ber2rv/fluidic/README.md

# fluidic
This repository contains the Electronics to control the pumps, in a fluidic system, among other things
