ber2rv/fluidic/fluidics/screengrabs/Bottom_Layer.png

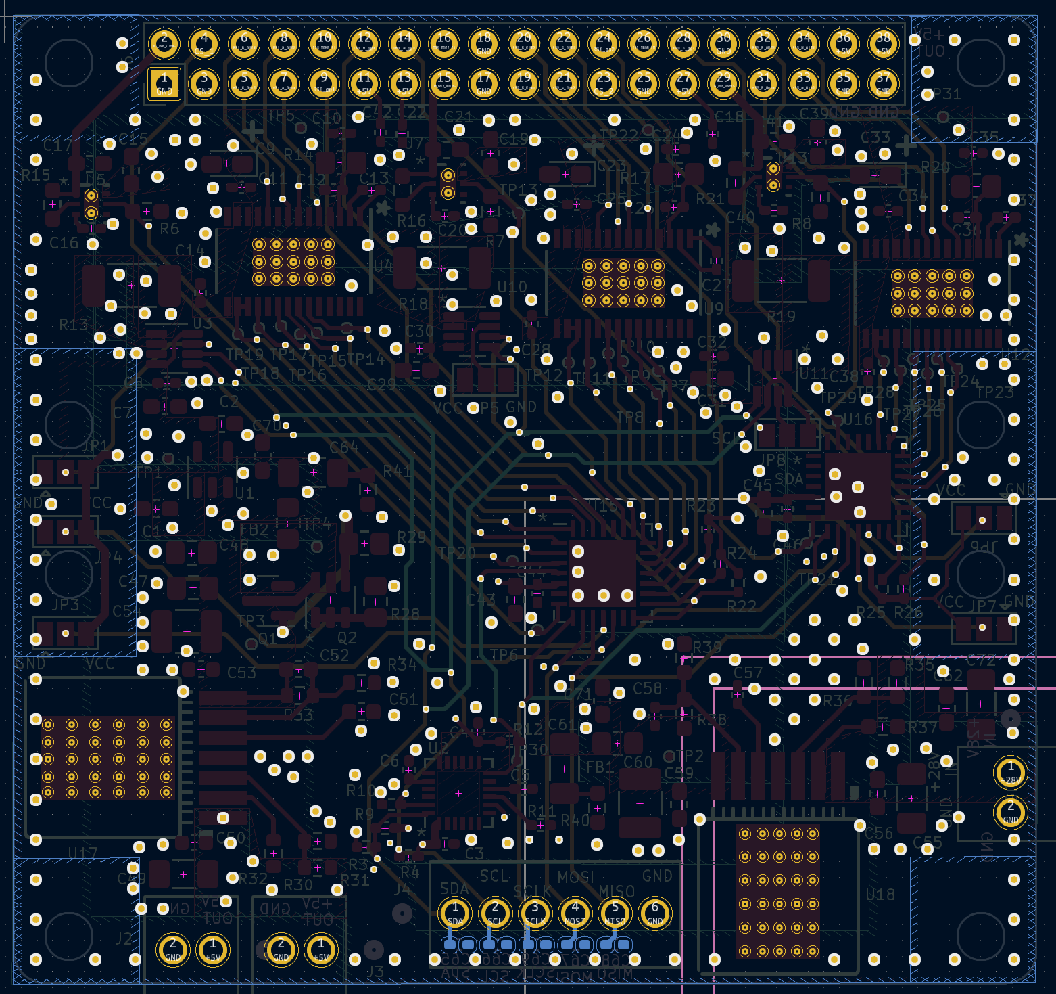
fluidics/screengrabs/Bottom_Layer.png
