ber2rv/fluidic/fluidics/screengrabs/Bottom_Layer_Cu_highlighted.png

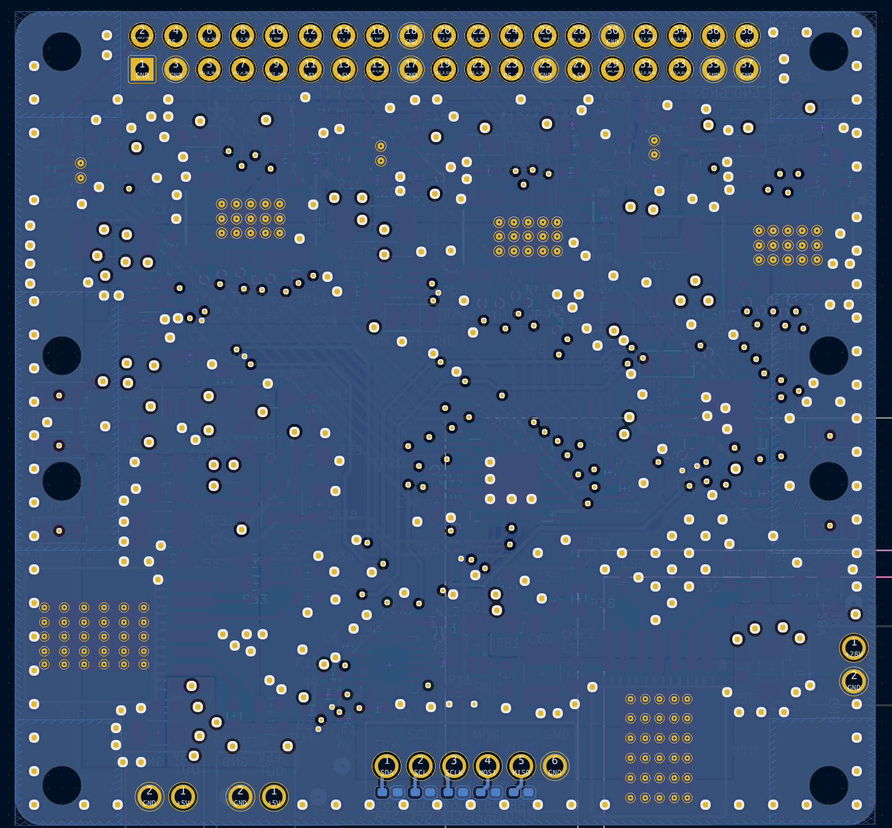
fluidics/screengrabs/Bottom_Layer_Cu_highlighted.png
