ber2rv/fluidic/fluidics/screengrabs/Inner_layer_1.png

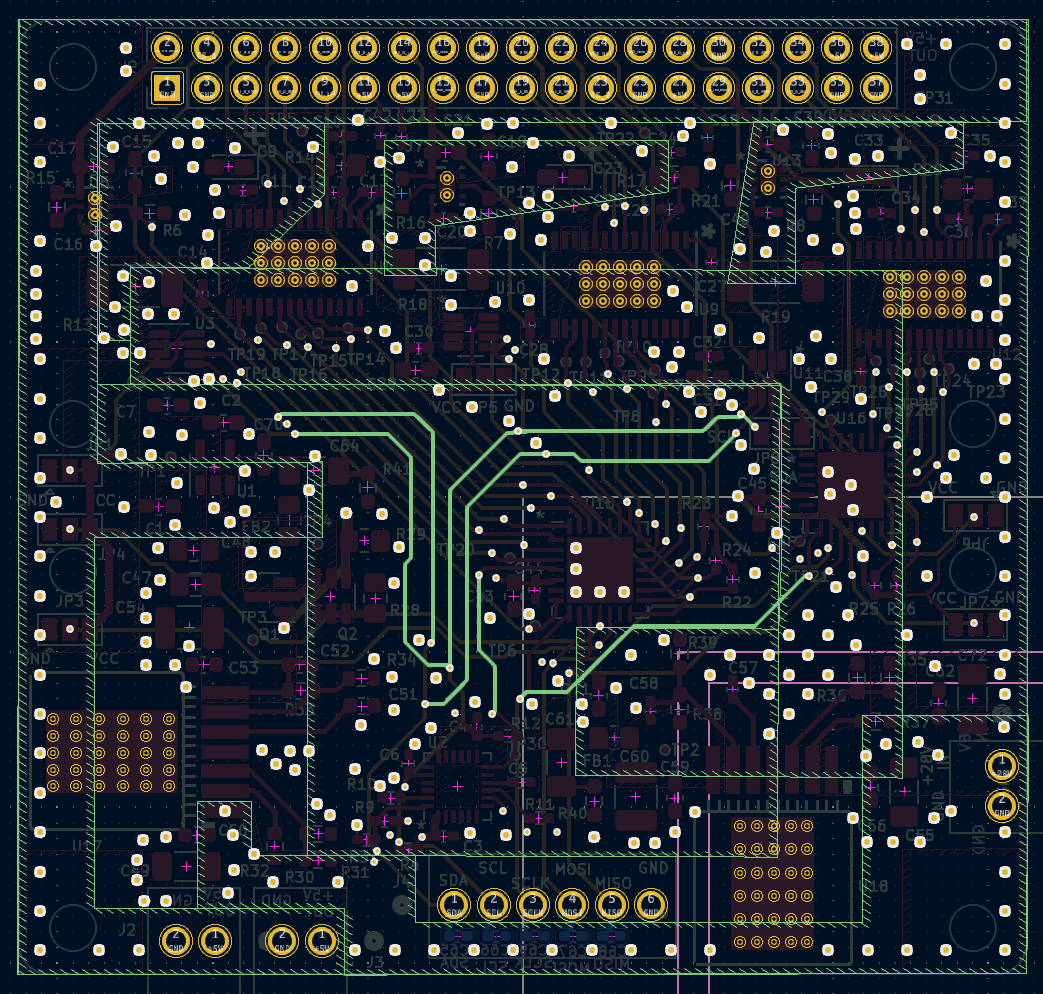
fluidics/screengrabs/Inner_layer_1.png
