ber2rv/fluidic/fluidics/screengrabs/Inner_layer_2.png

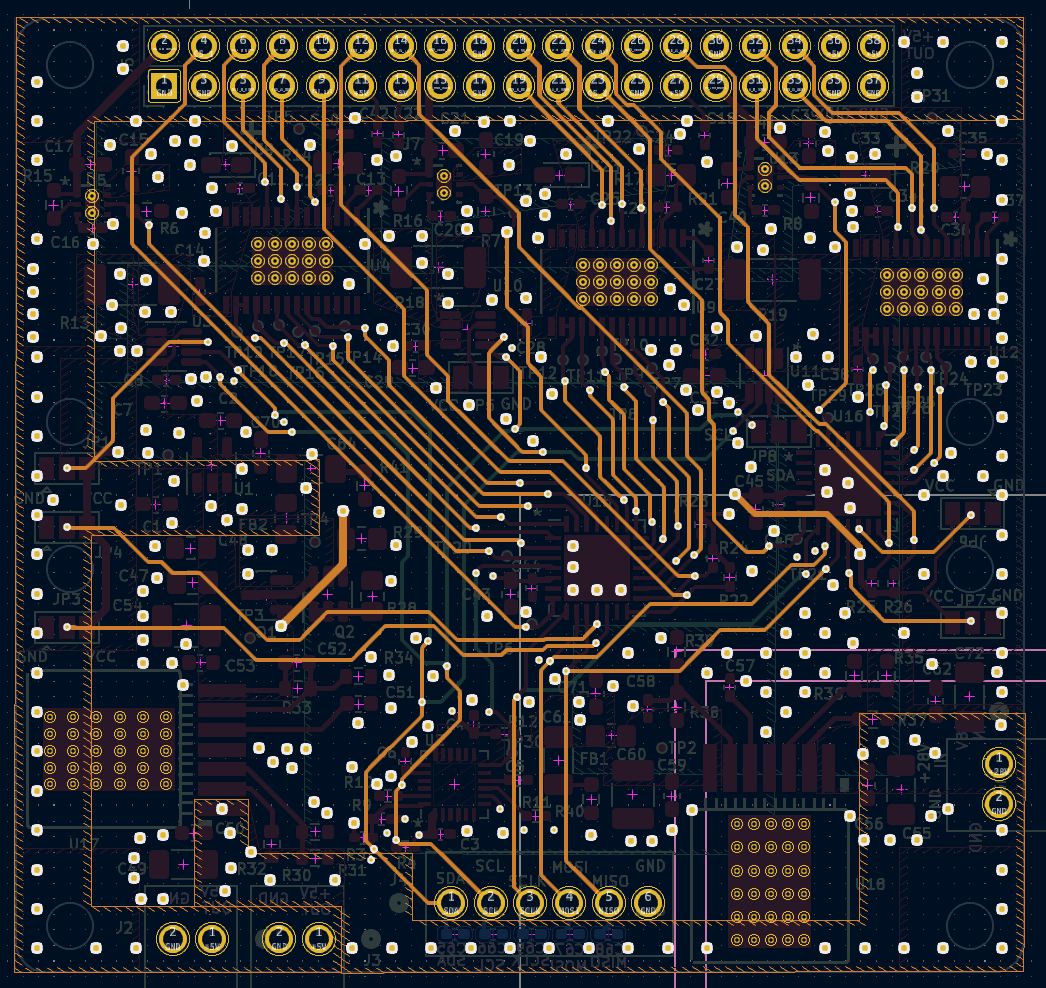
fluidics/screengrabs/Inner_layer_2.png
