ber2rv/fluidic/fluidics/screengrabs/Inner_layer_2_Cu_highlighted.png

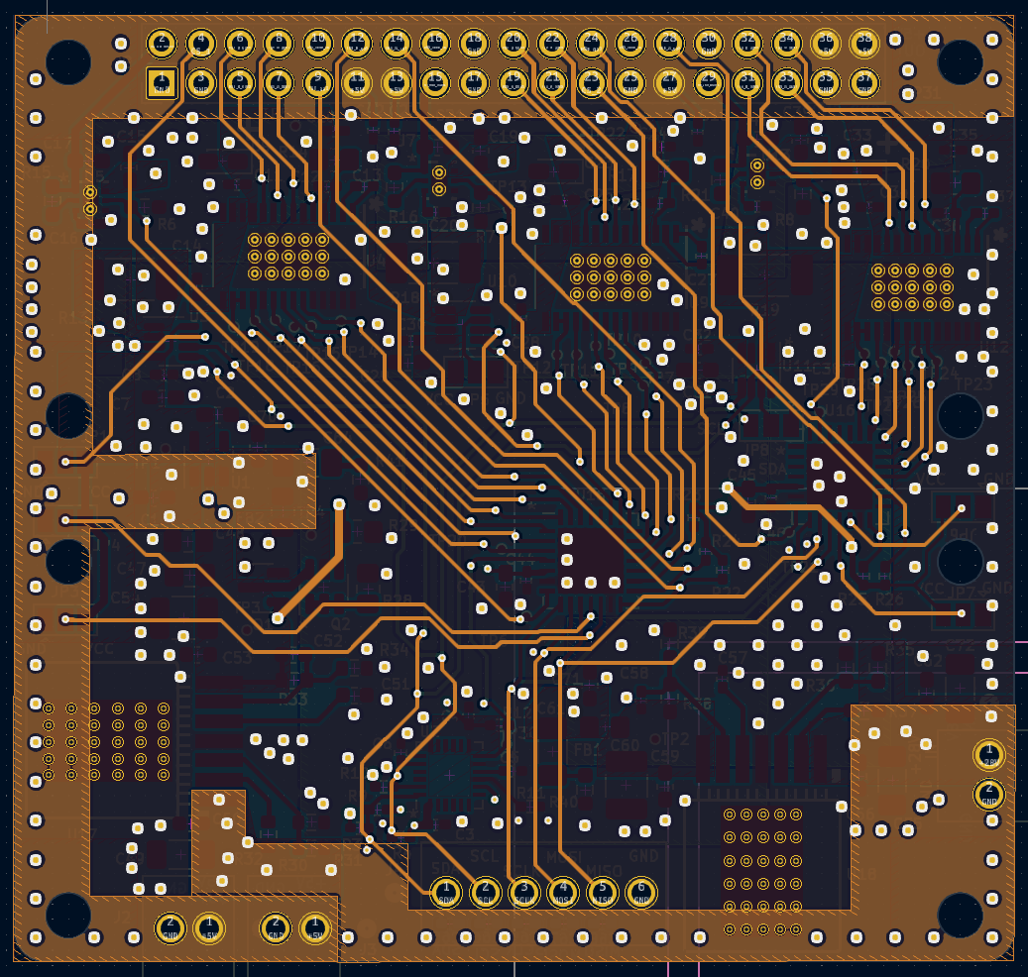
fluidics/screengrabs/Inner_layer_2_Cu_highlighted.png
