ber2rv/fluidic/fluidics/screengrabs/Top_Layer.png

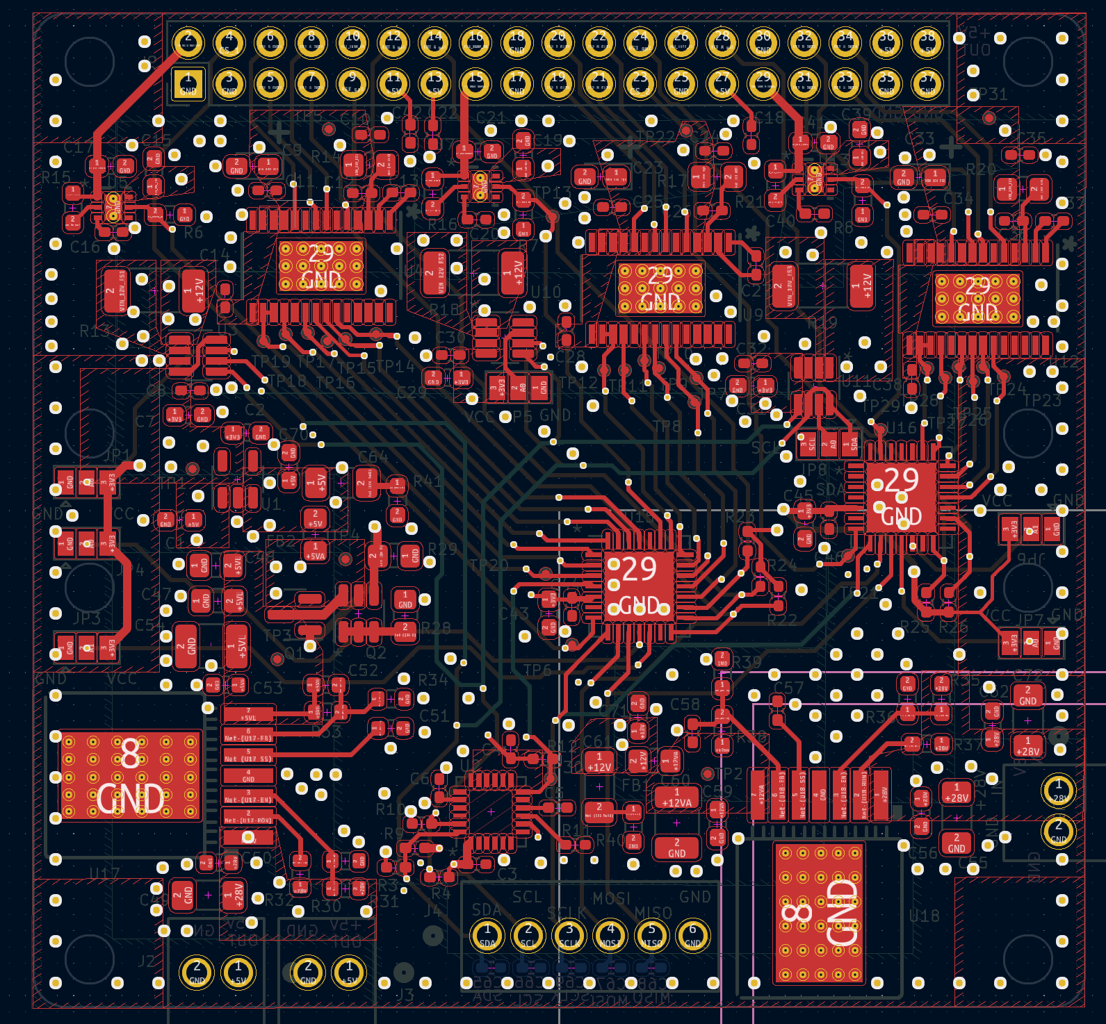
fluidics/screengrabs/Top_Layer.png
