ber2rv/fluidic/fluidics/screengrabs/Top_Layer_Cu_highlighted.png

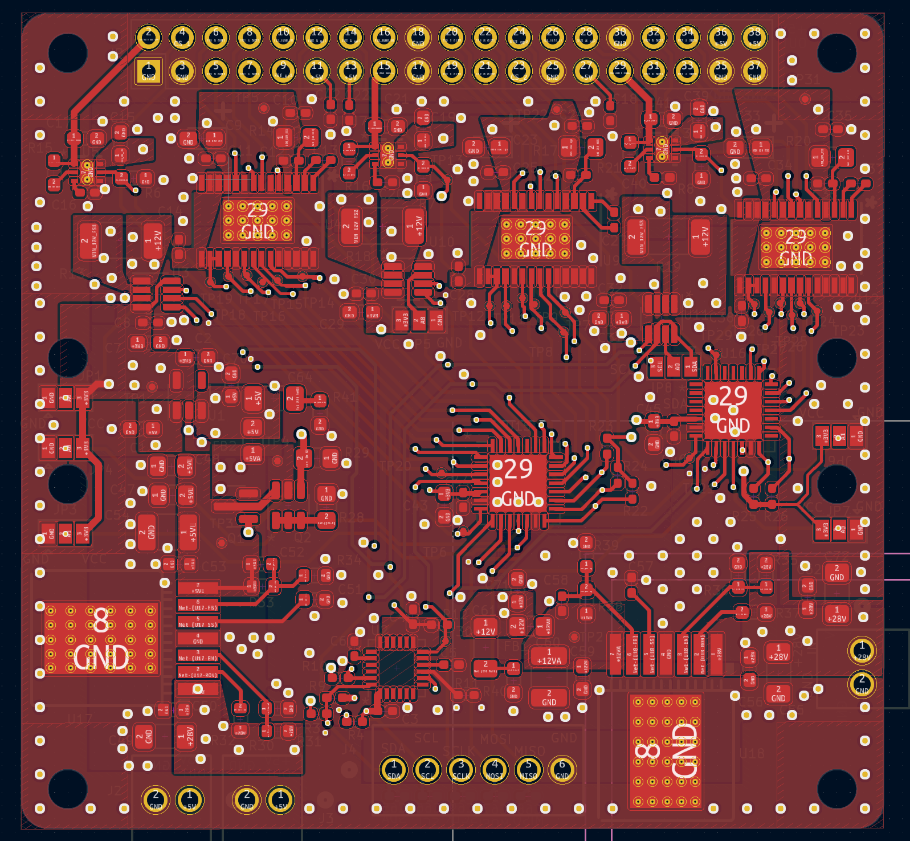
fluidics/screengrabs/Top_Layer_Cu_highlighted.png
