ber2rv/fluidic/fluidics/schematics_pdf/fluidics.pdf

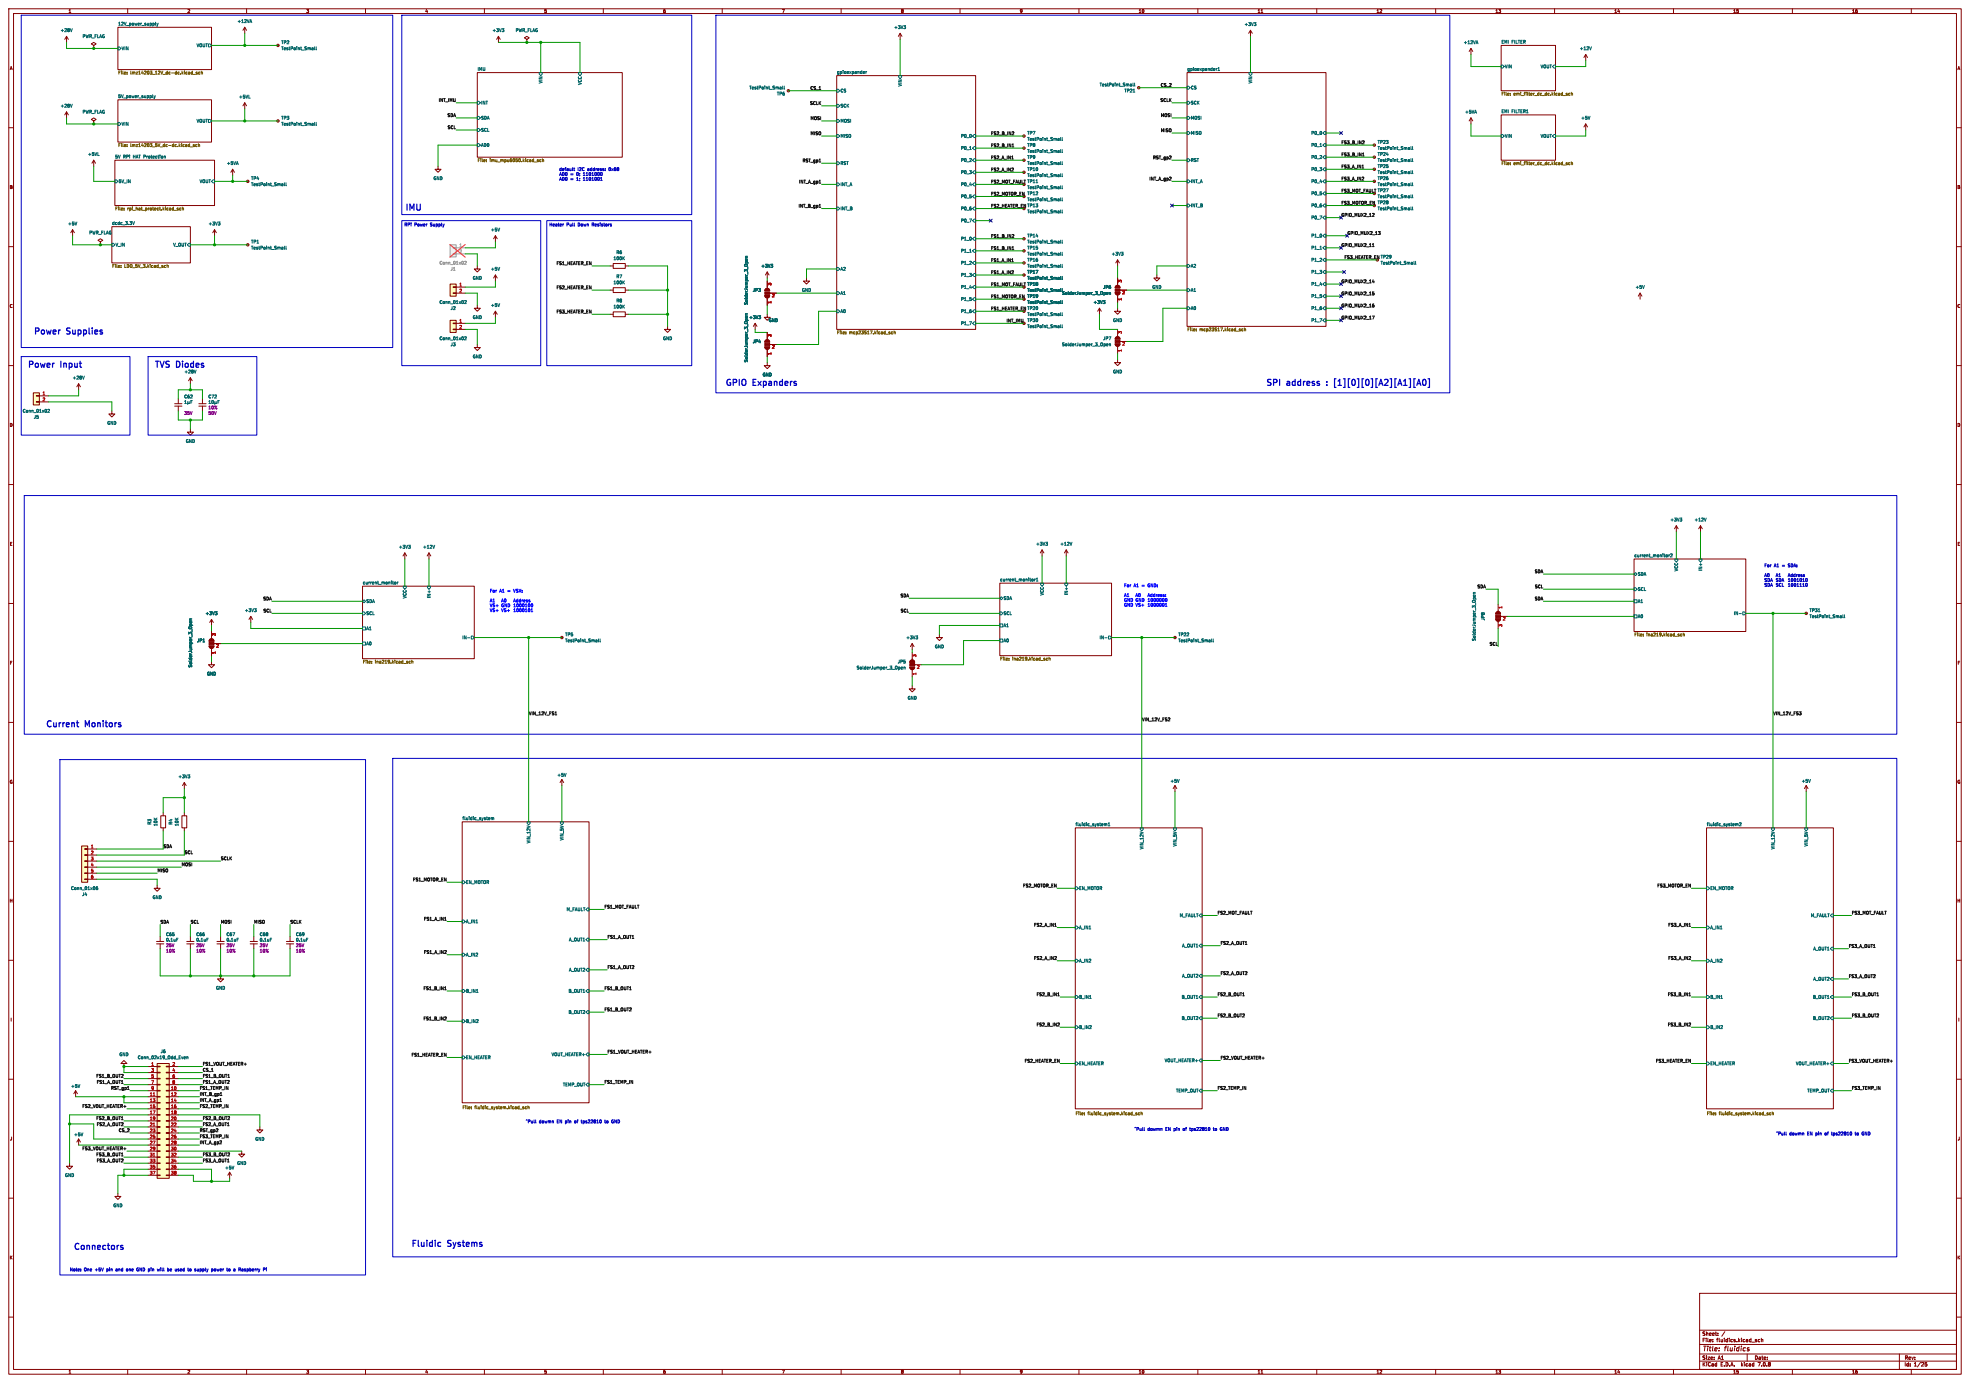
[picture p9: page 1]

For A1 = SDA: A0 A1 Address SDA SDA 1001010 SDA SCL 1001110

For A1 = GND: A1 A0 Address: GND GND 1000000 GND VS+ 1000001

For A1 = VSX: A1 A0 Address VS+ GND 1000100 VS+ VS+ 1000101

Note: One +5V pin and one GND pin will be used to supply power to a Raspberry Pi

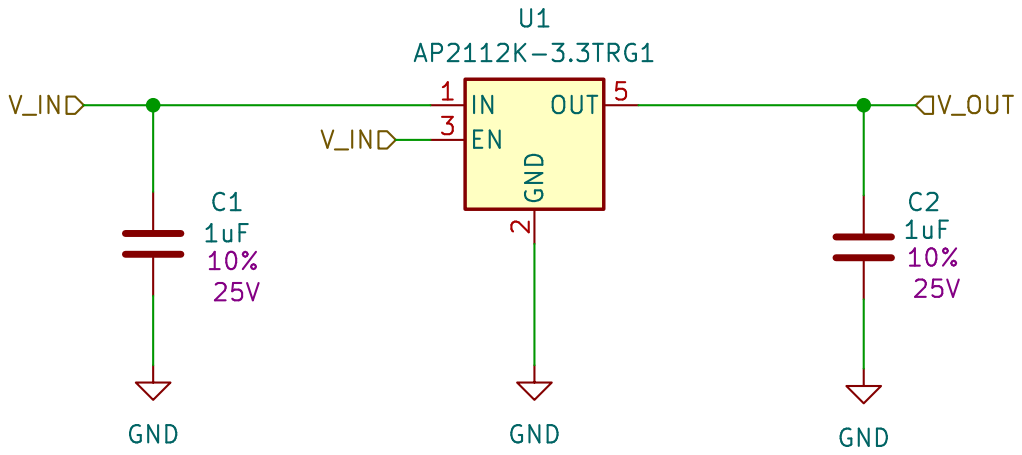
[picture p10: page 2]

Id: 2/25 Title: File: LDO_5V_3.kicad_sch Sheet: /dcdc_3.3V/ Yuri GmbH

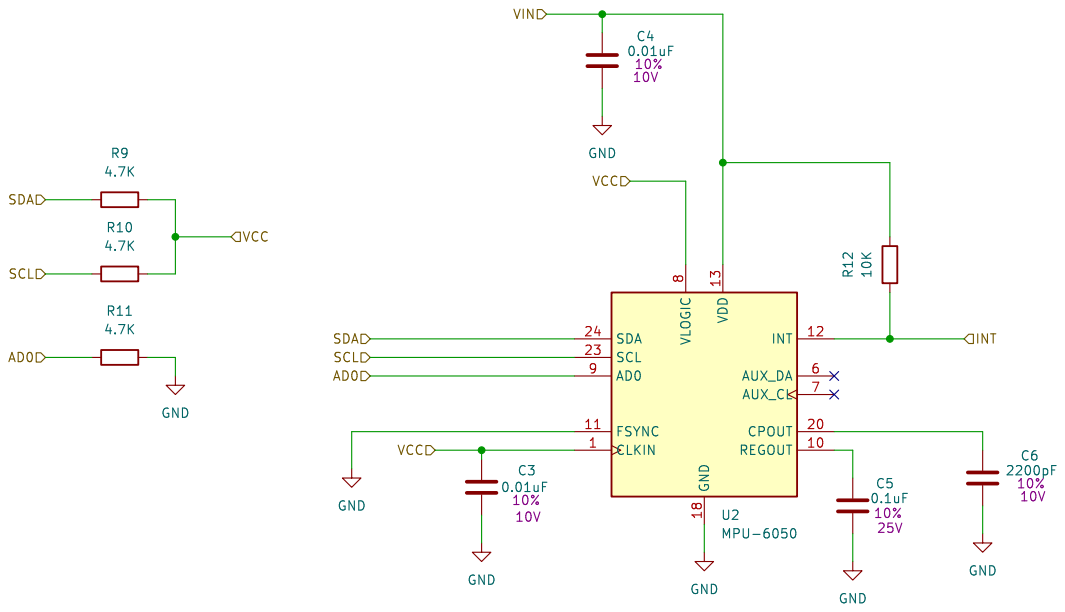
[picture p11: page 3]

Id: 3/25 Title: File: imu_mpu6050.kicad_sch Sheet: /IMU/ Yuri GmbH

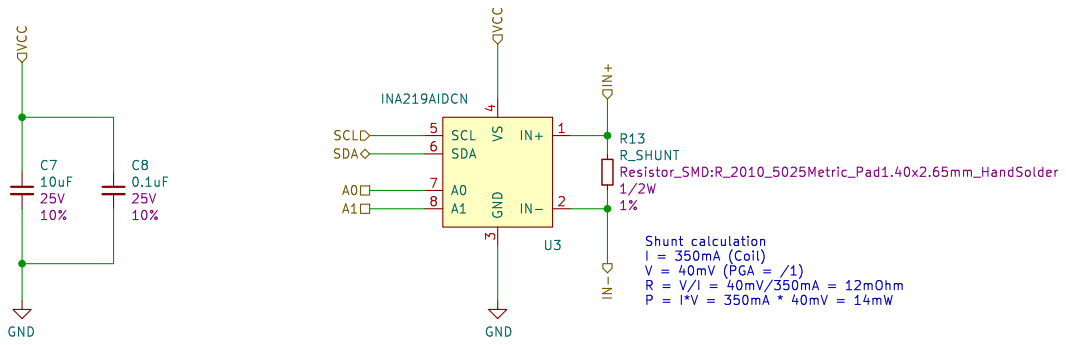
[picture p12: page 4]

Id: 4/25 Title: File: ina219.kicad_sch Sheet: /current_monitor/ Yuri GmbH

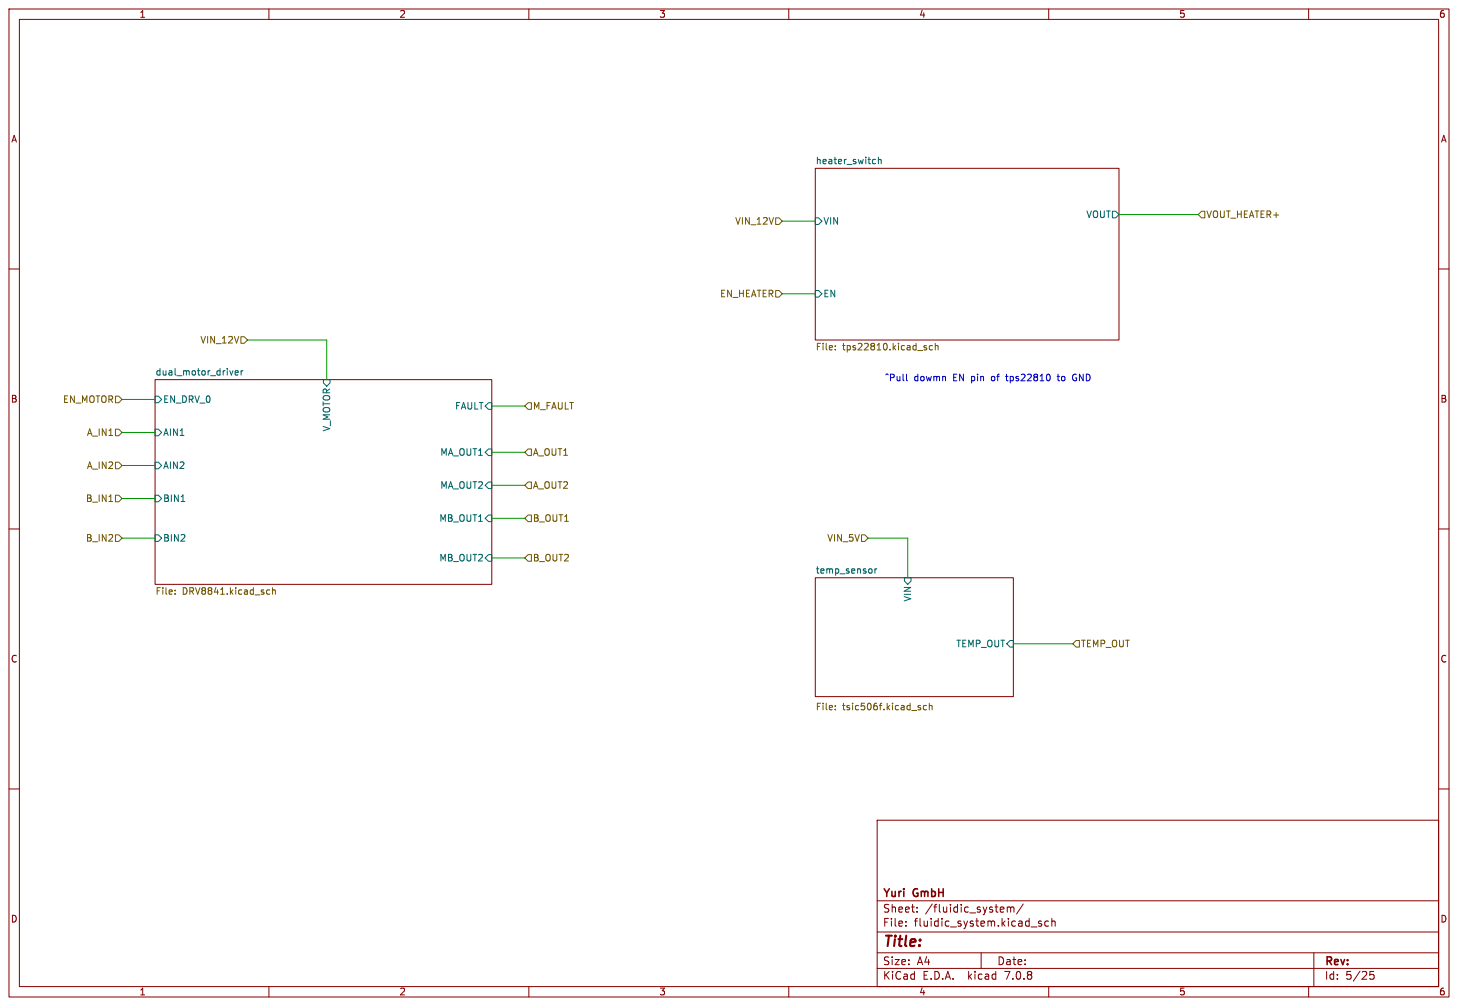
[picture p13: page 5]

Id: 5/25 Title: File: fluidic_system.kicad_sch Sheet: /fluidic_system/ Yuri GmbH VIN

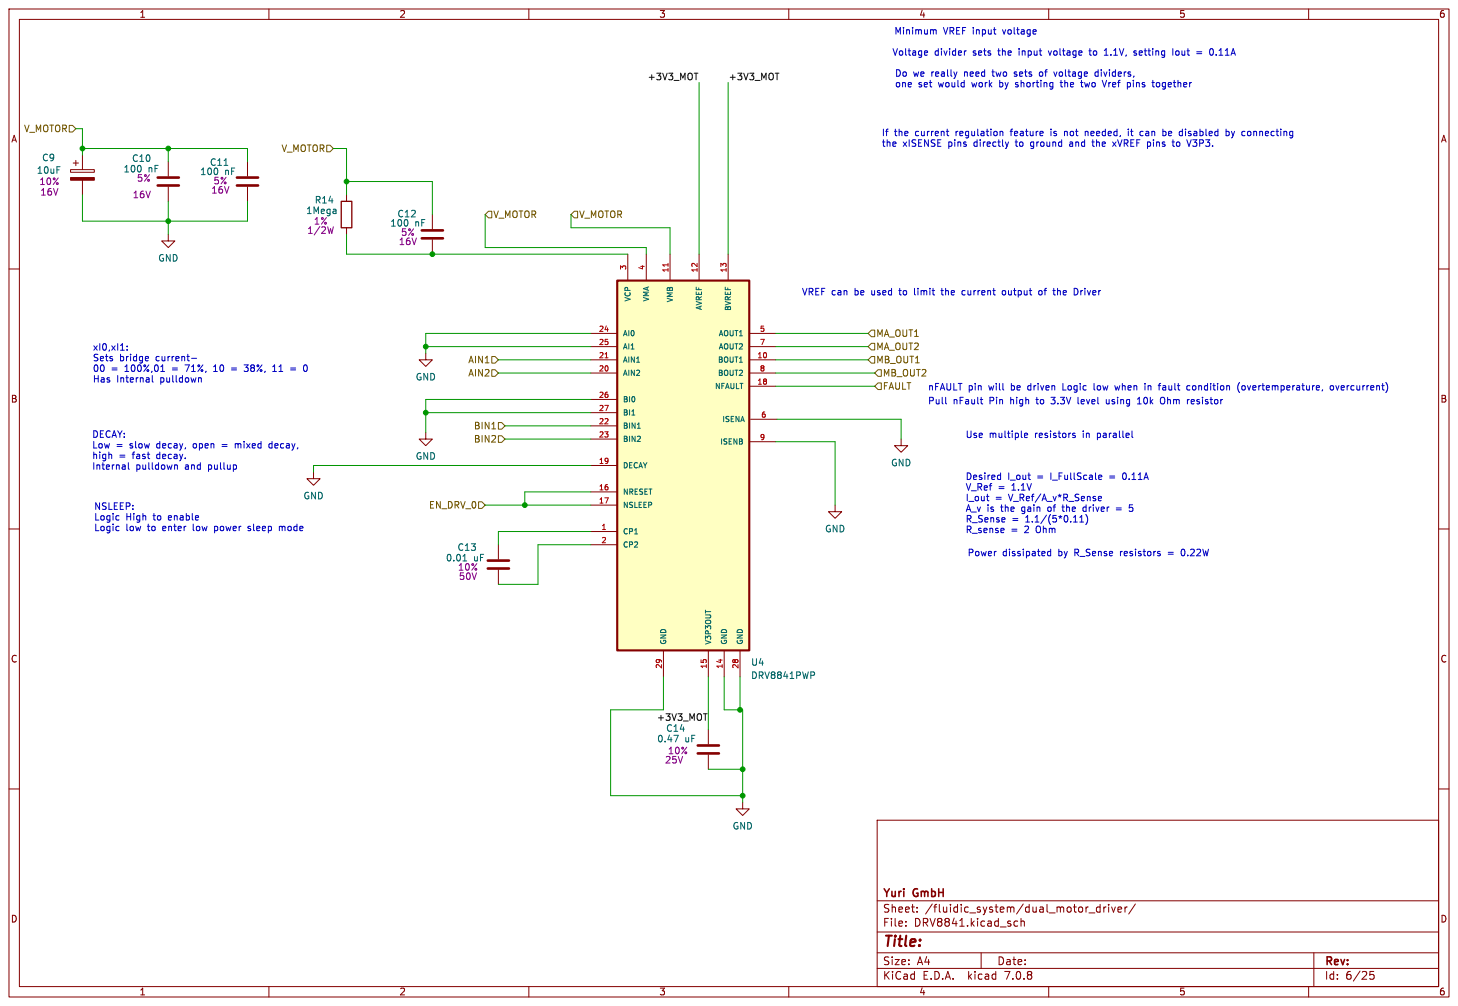
[picture p14: page 6]

V_Ref = 1.1V
I_out = V_Ref/A_v*R_Sense A_v is the gain of the driver = 5 R_Sense = 1.1/(5*0.11) R_sense = 2 Ohm

Logic low to enter low power sleep mode

Id: 6/25 Title: File: DRV8841.kicad_sch Sheet: /fluidic_system/dual_motor_driver/ Yuri GmbH

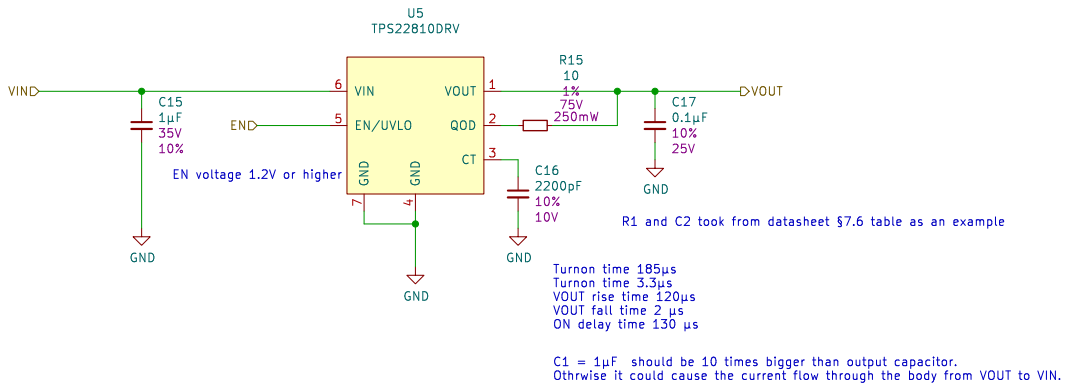
[picture p15: page 7]

4 EN/UVLO 5 VIN 6 GND

Id: 7/25 Title: File: tps22810.kicad_sch Sheet: /fluidic_system/heater_switch/ Yuri GmbH

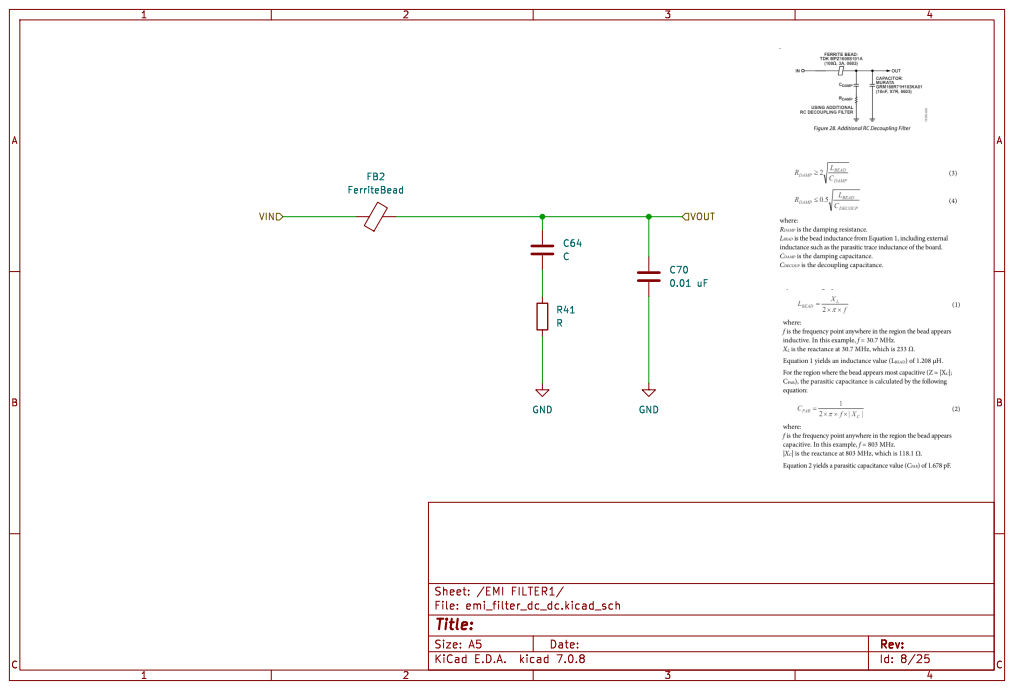
[picture p16: page 8]

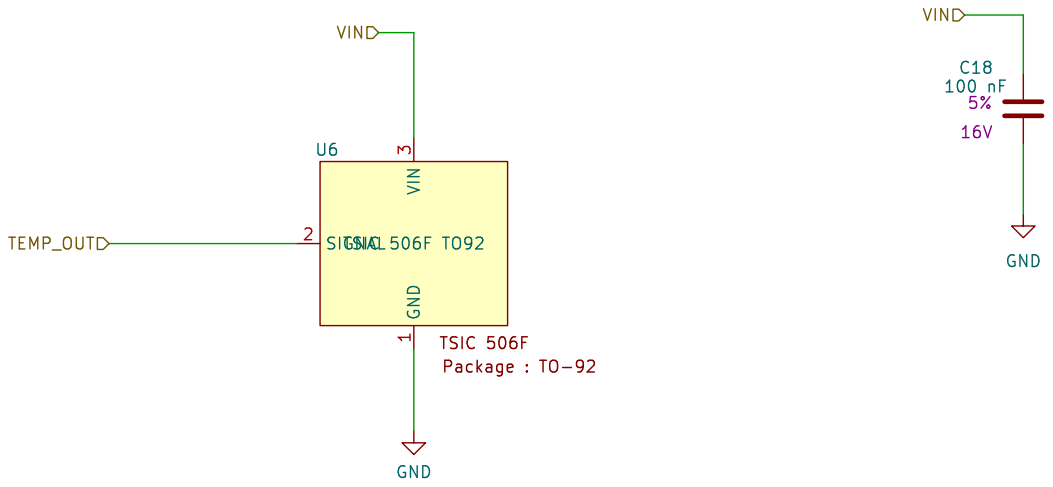
[picture p17: page 9]

Package : TO-92 TSIC 506F GND

Id: 9/25 Title: File: tsic506f.kicad_sch Sheet: /fluidic_system/temp_sensor/ Yuri GmbH

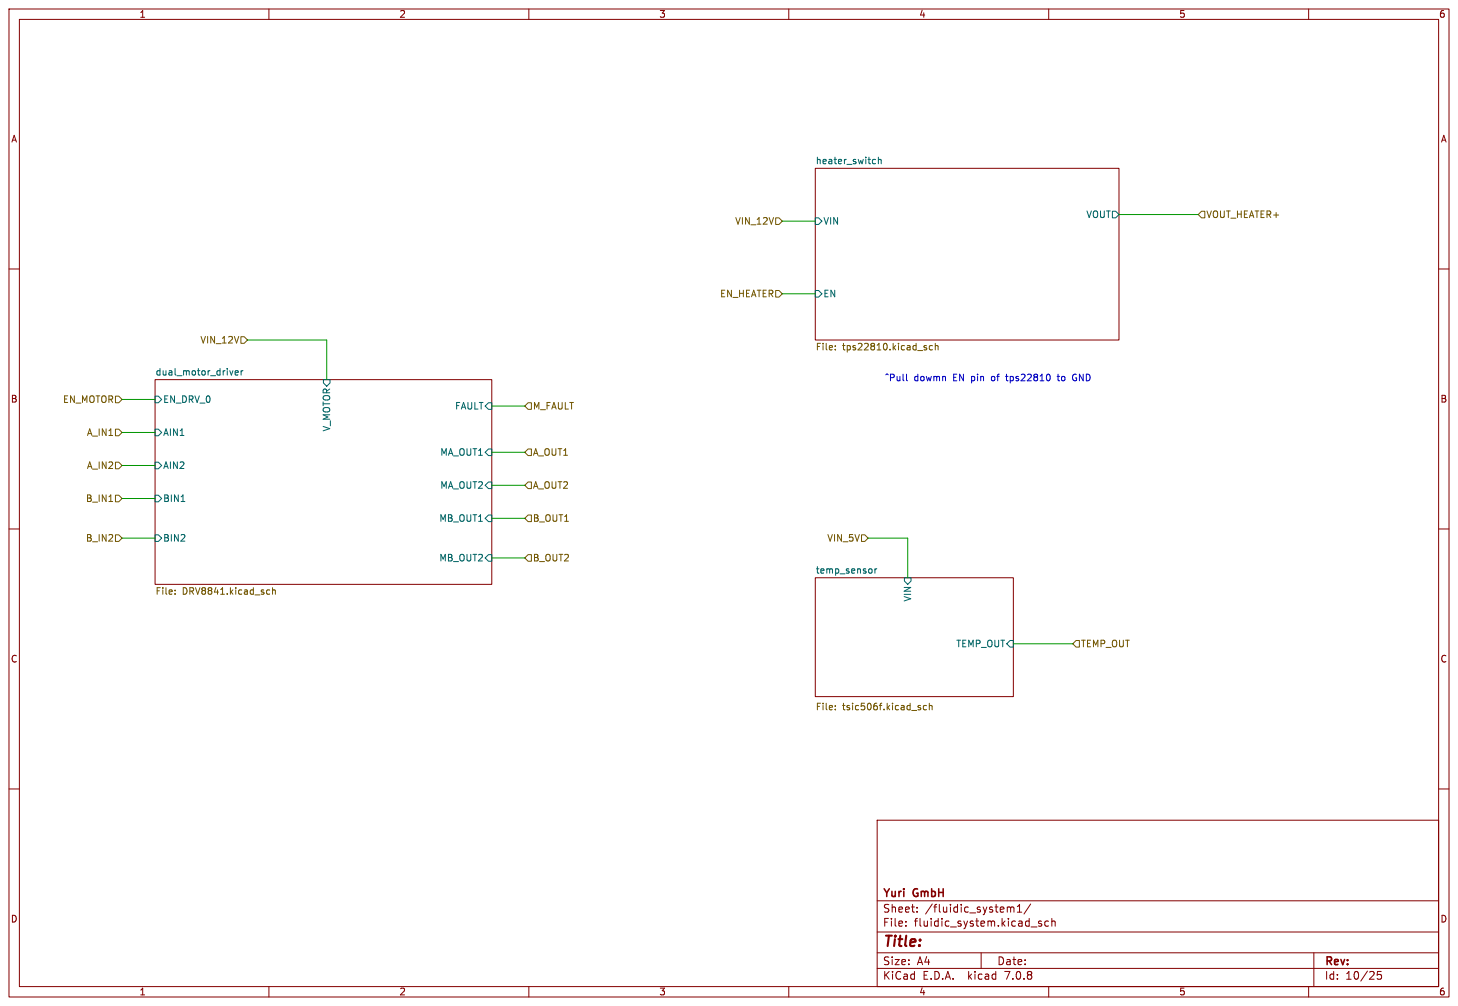
[picture p18: page 10]

Id: 10/25 Title: File: fluidic_system.kicad_sch Sheet: /fluidic_system1/ Yuri GmbH VIN

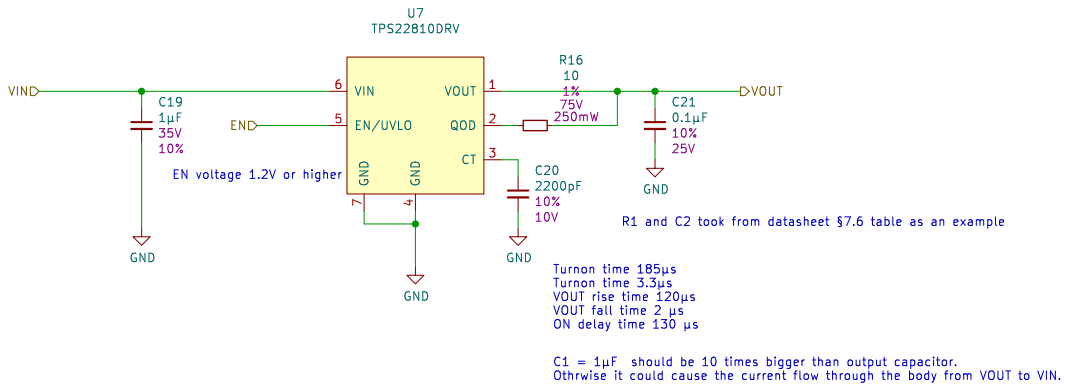
[picture p19: page 11]

4 EN/UVLO 5 VIN 6 GND

Id: 11/25 Title: File: tps22810.kicad_sch Sheet: /fluidic_system1/heater_switch/ Yuri GmbH

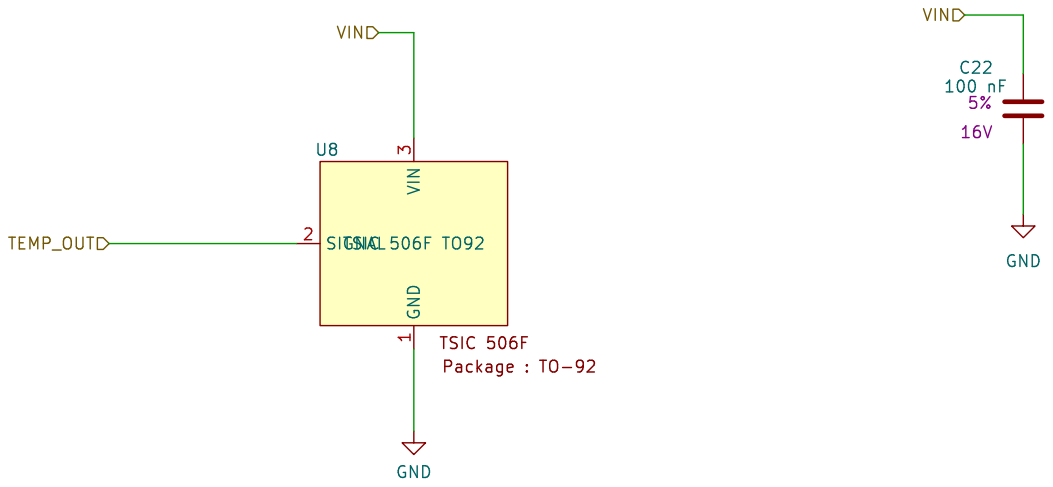
[picture p20: page 12]

Package : TO-92 TSIC 506F GND

Id: 12/25 Title: File: tsic506f.kicad_sch Sheet: /fluidic_system1/temp_sensor/ Yuri GmbH

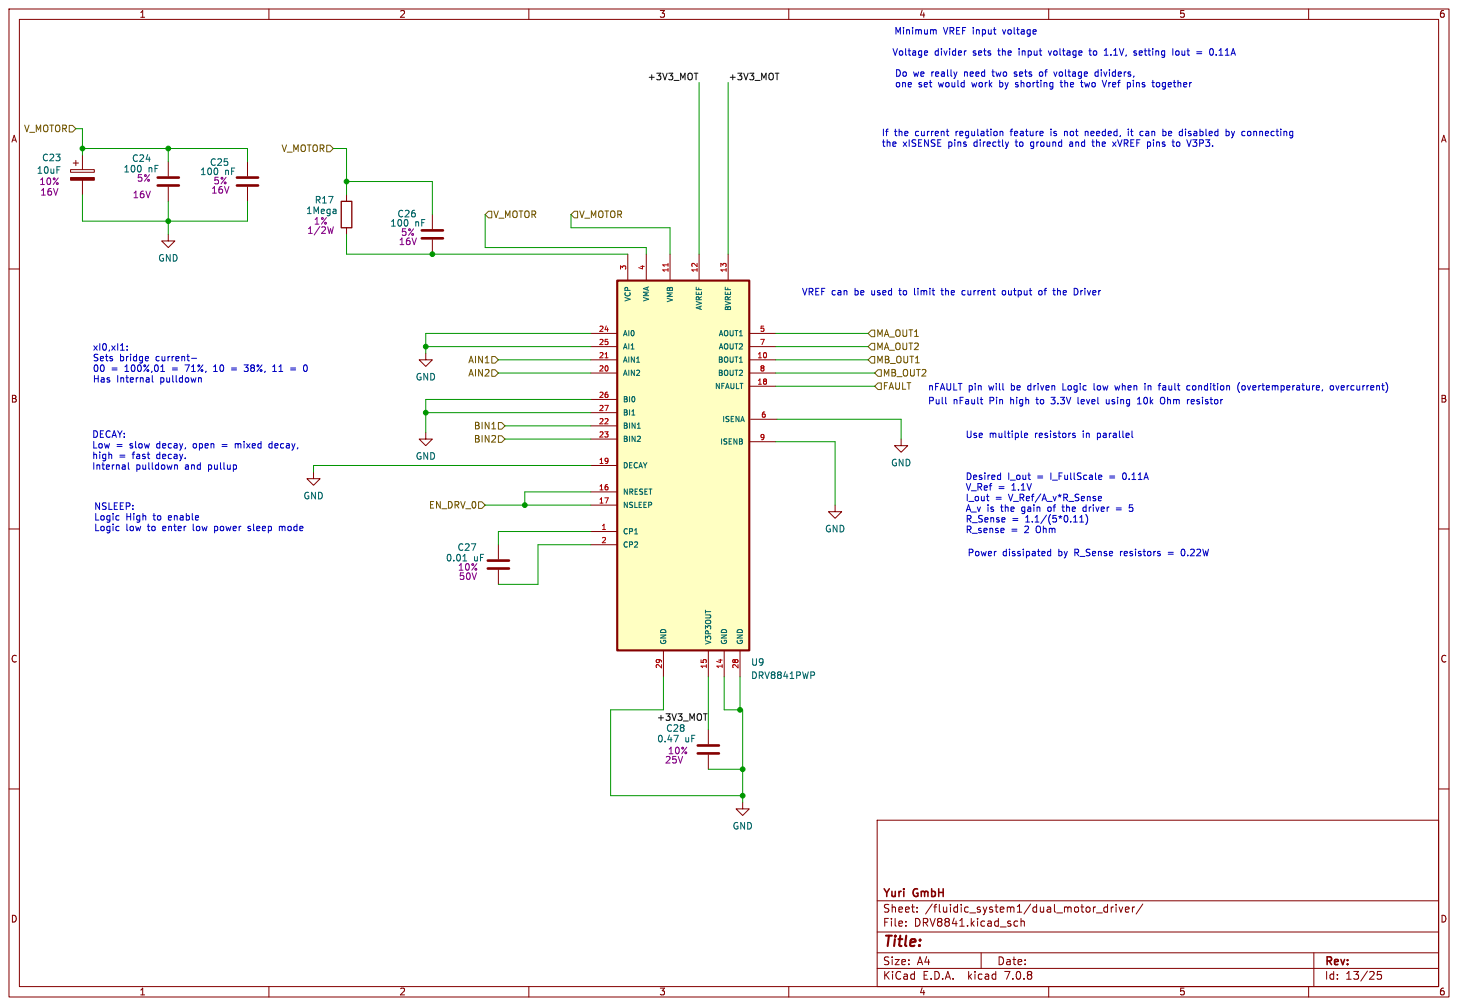
[picture p21: page 13]
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

Logic low to enter low power sleep mode

Id: 13/25 Title: File: DRV8841.kicad_sch Sheet: /fluidic_system1/dual_motor_driver/ Yuri GmbH

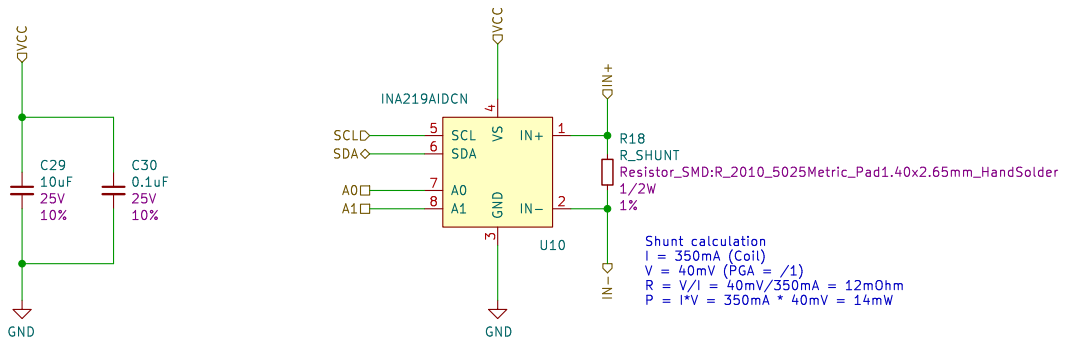
[picture p22: page 14]

Id: 14/25 Title: File: ina219.kicad_sch Sheet: /current_monitor1/ Yuri GmbH

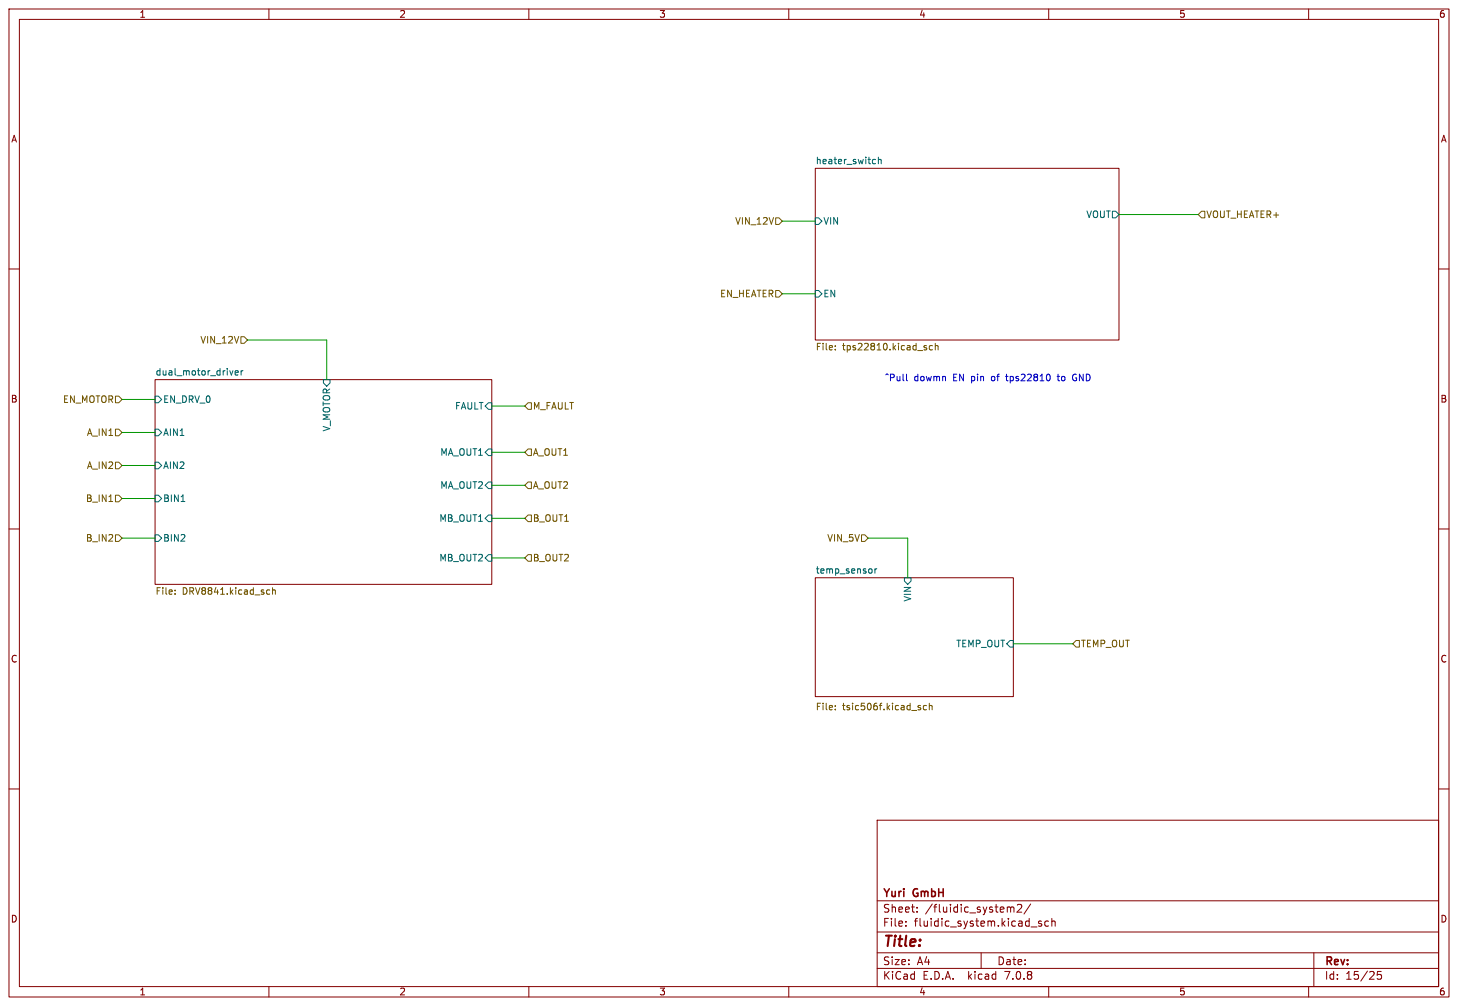
[picture p23: page 15]

Id: 15/25 Title: File: fluidic_system.kicad_sch Sheet: /fluidic_system2/ Yuri GmbH VIN

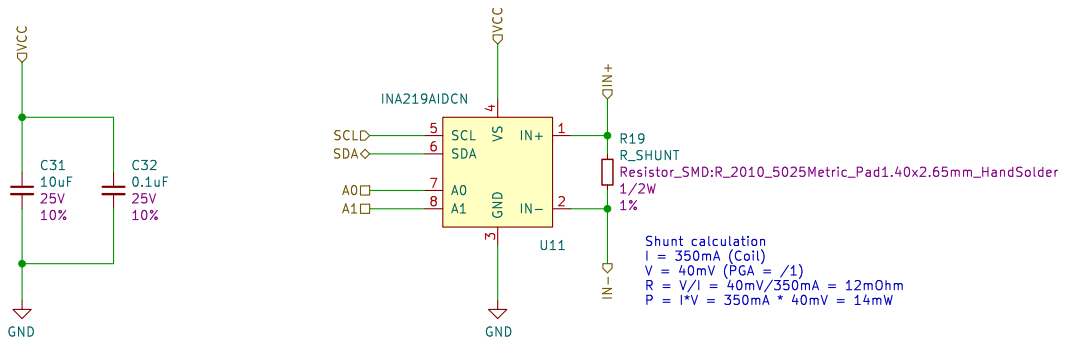
[picture p24: page 16]

Id: 16/25 Title: File: ina219.kicad_sch Sheet: /current_monitor2/ Yuri GmbH

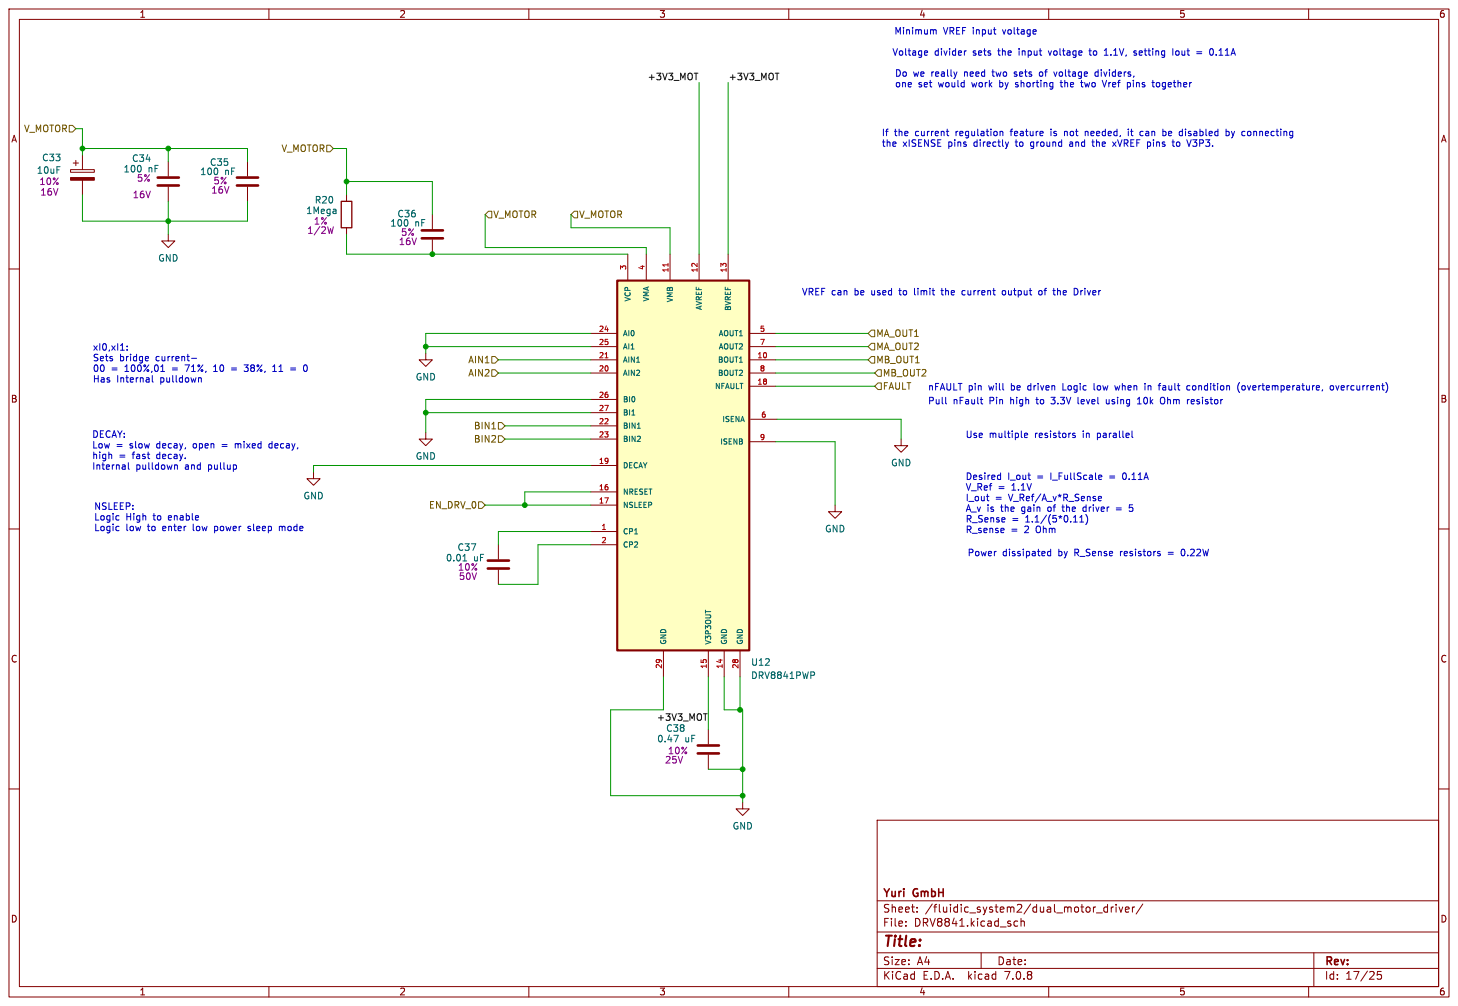
[picture p25: page 17]
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

Logic low to enter low power sleep mode

Id: 17/25 Title: File: DRV8841.kicad_sch Sheet: /fluidic_system2/dual_motor_driver/ Yuri GmbH

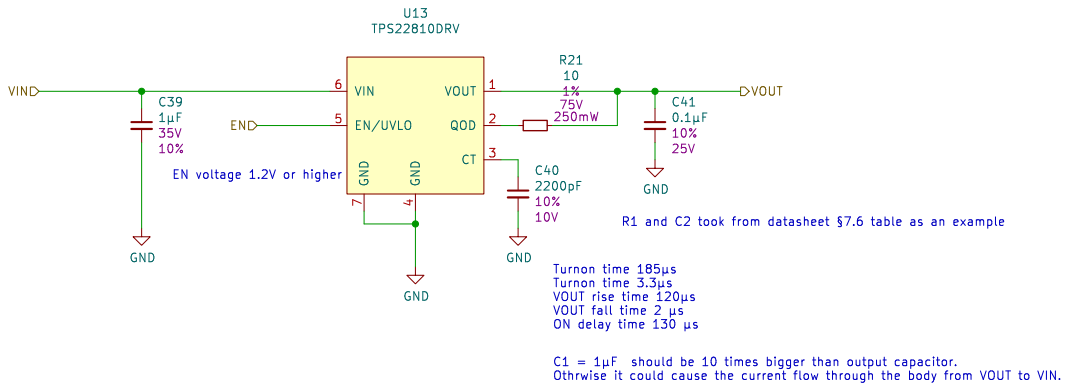
[picture p26: page 18]

4 EN/UVLO 5 VIN 6 GND

Id: 18/25 Title: File: tps22810.kicad_sch Sheet: /fluidic_system2/heater_switch/ Yuri GmbH

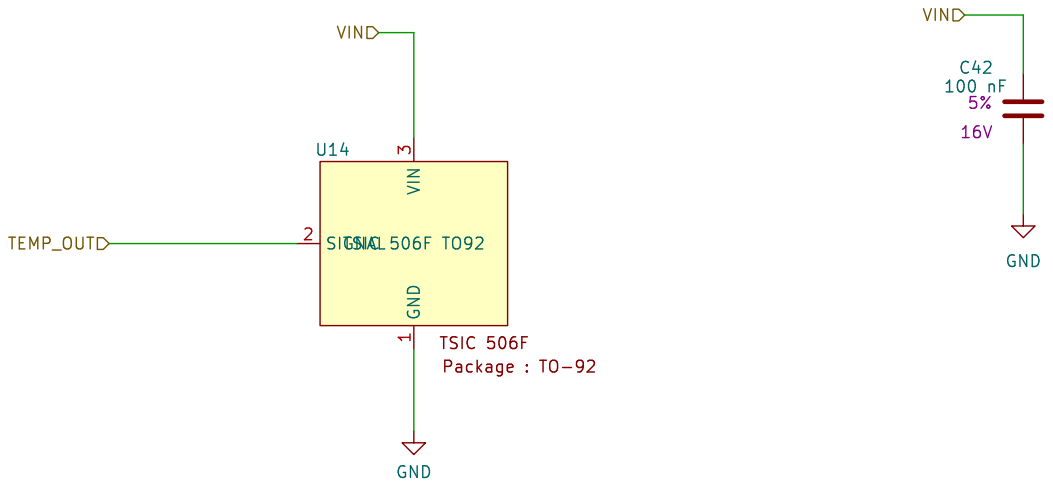
[picture p27: page 19]

Package : TO-92 TSIC 506F GND

Id: 19/25 Title: File: tsic506f.kicad_sch Sheet: /fluidic_system2/temp_sensor/ Yuri GmbH

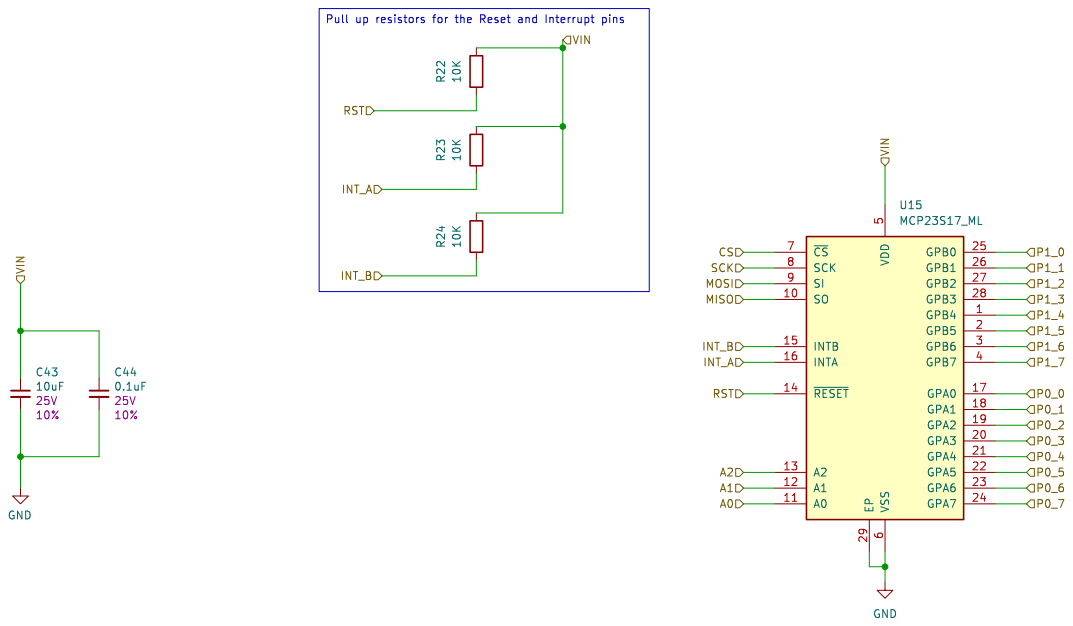
[picture p28: page 20]

Id: 21/25 Title: File: mcp23S17.kicad_sch Sheet: /gpioexpander/ Yuri GmbH

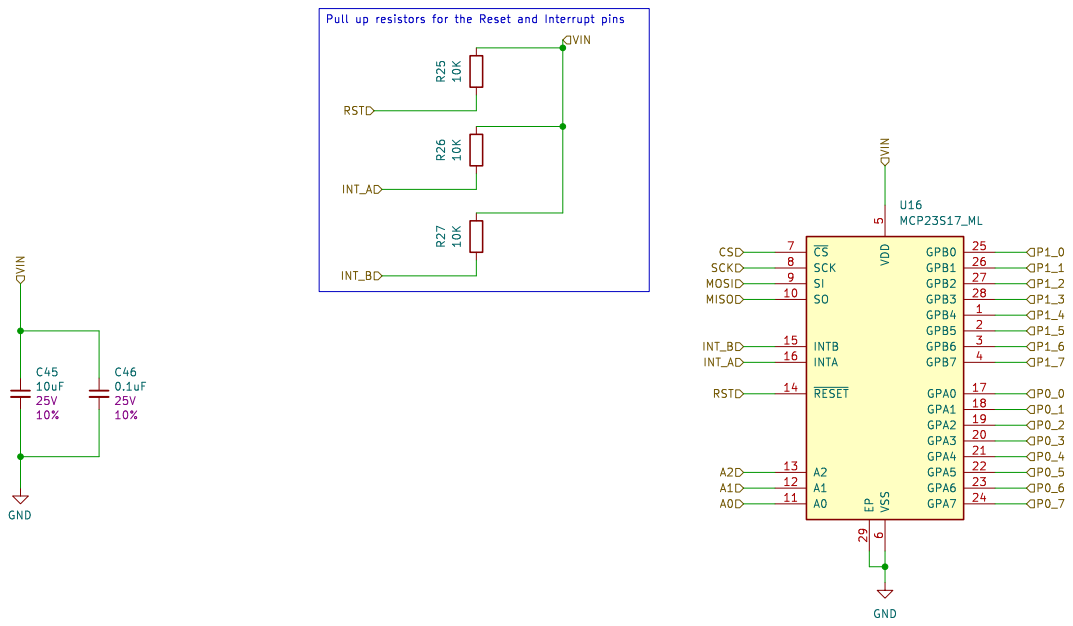
[picture p29: page 21]

Id: 22/25 Title: File: mcp23S17.kicad_sch Sheet: /gpioexpander1/ Yuri GmbH

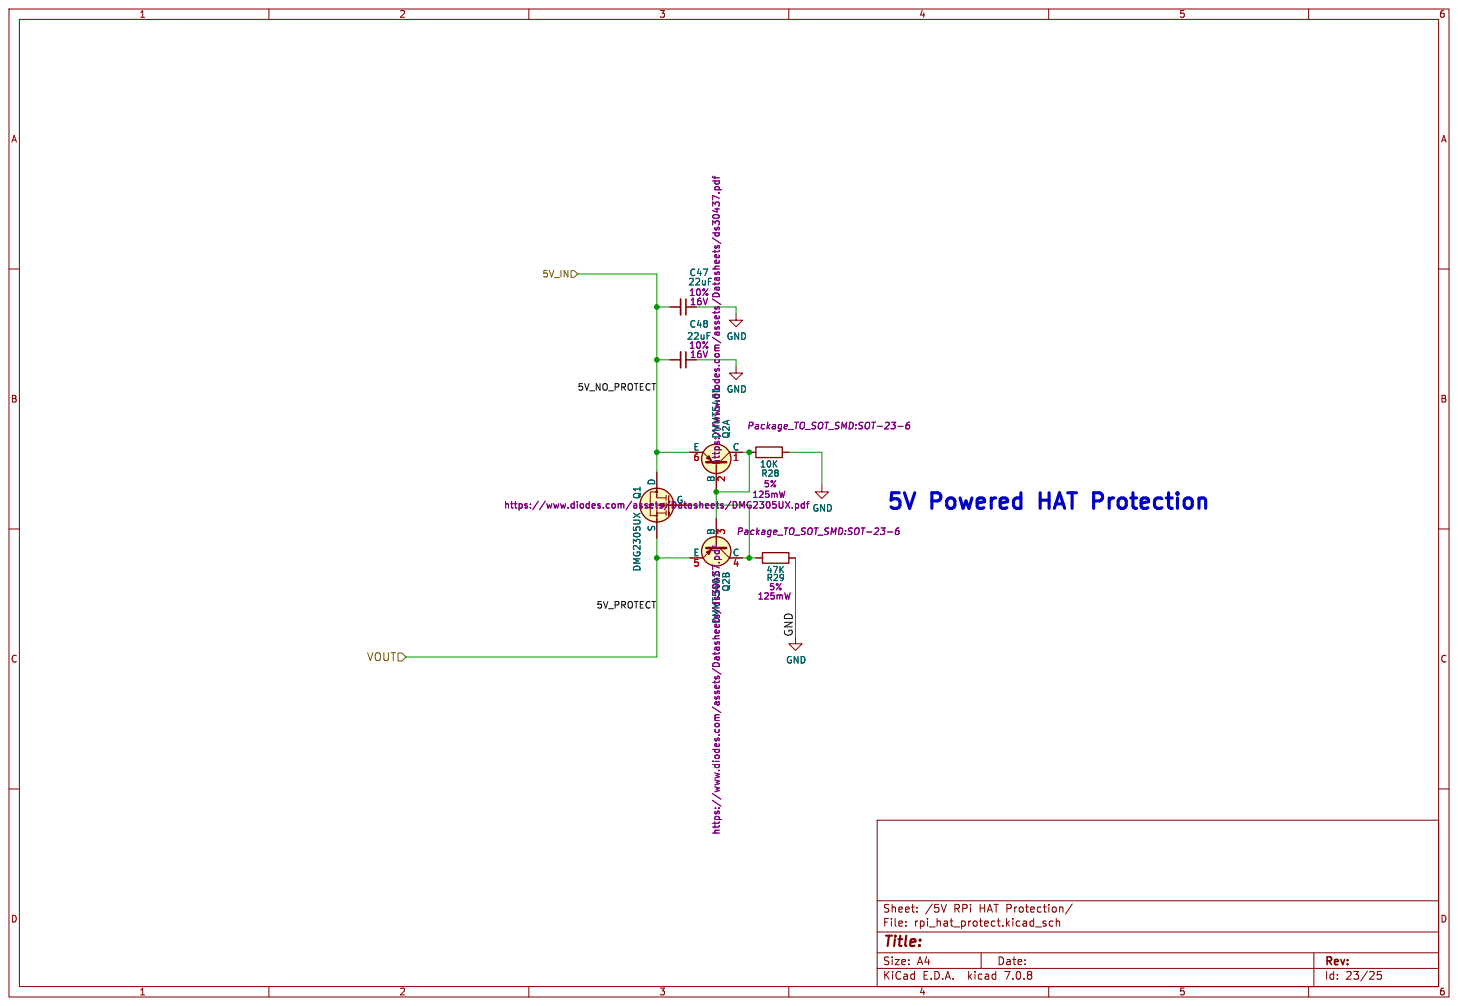
[picture p30: page 22]

https://www.diodes.com/assets/Datasheets/DMG2305UX.pdf G S D

Package_TO_SOT_SMD:SOT-23-6 https://www.diodes.com/assets/Datasheets/ds30437.pdf VOUT

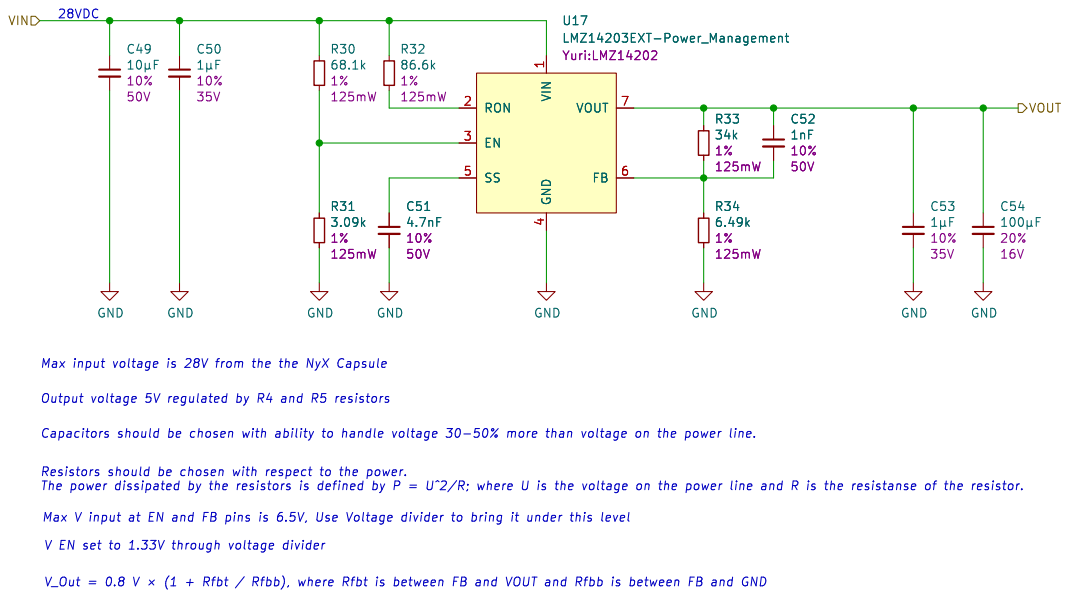
[picture p31: page 23]

Id: 23/25 Title: File: lmz14203_5V_dc-dc.kicad_sch Sheet: /5V_power_supply/ VIN

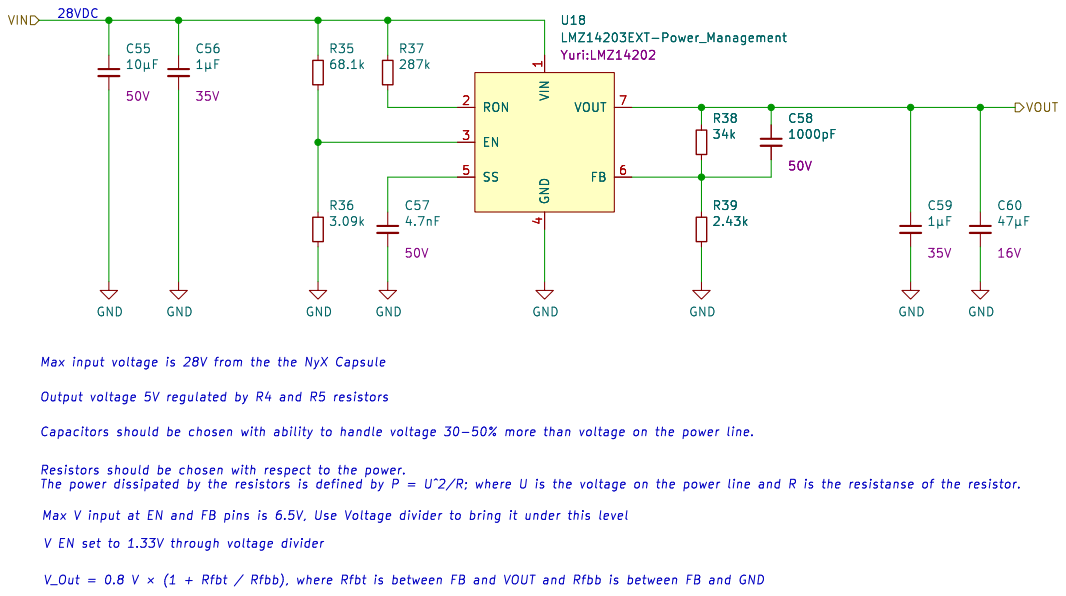
[picture p32: page 24]

Id: 24/25 Title: File: lmz14203_12V_dc-dc.kicad_sch Sheet: /12V_power_supply/ Yuri GmbH

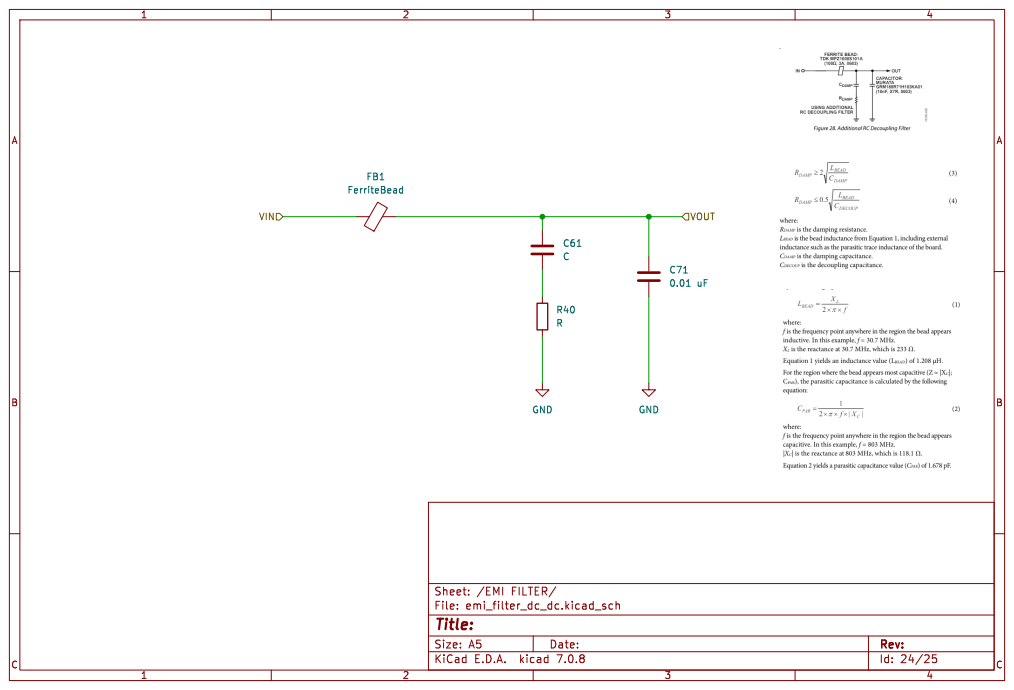
[picture p33: page 25]
