ber2rv/fluidic/(list of files, drawings)

Other design files:
fluidics/freerouting.dsn
