ber2rv/fluidic/fluidics/BD9D321EFJ-E2_dcdc_5V.kicad_sch

## KiCad design fluidics/BD9D321EFJ-E2_dcdc_5V.kicad_sch (2024-05-15)

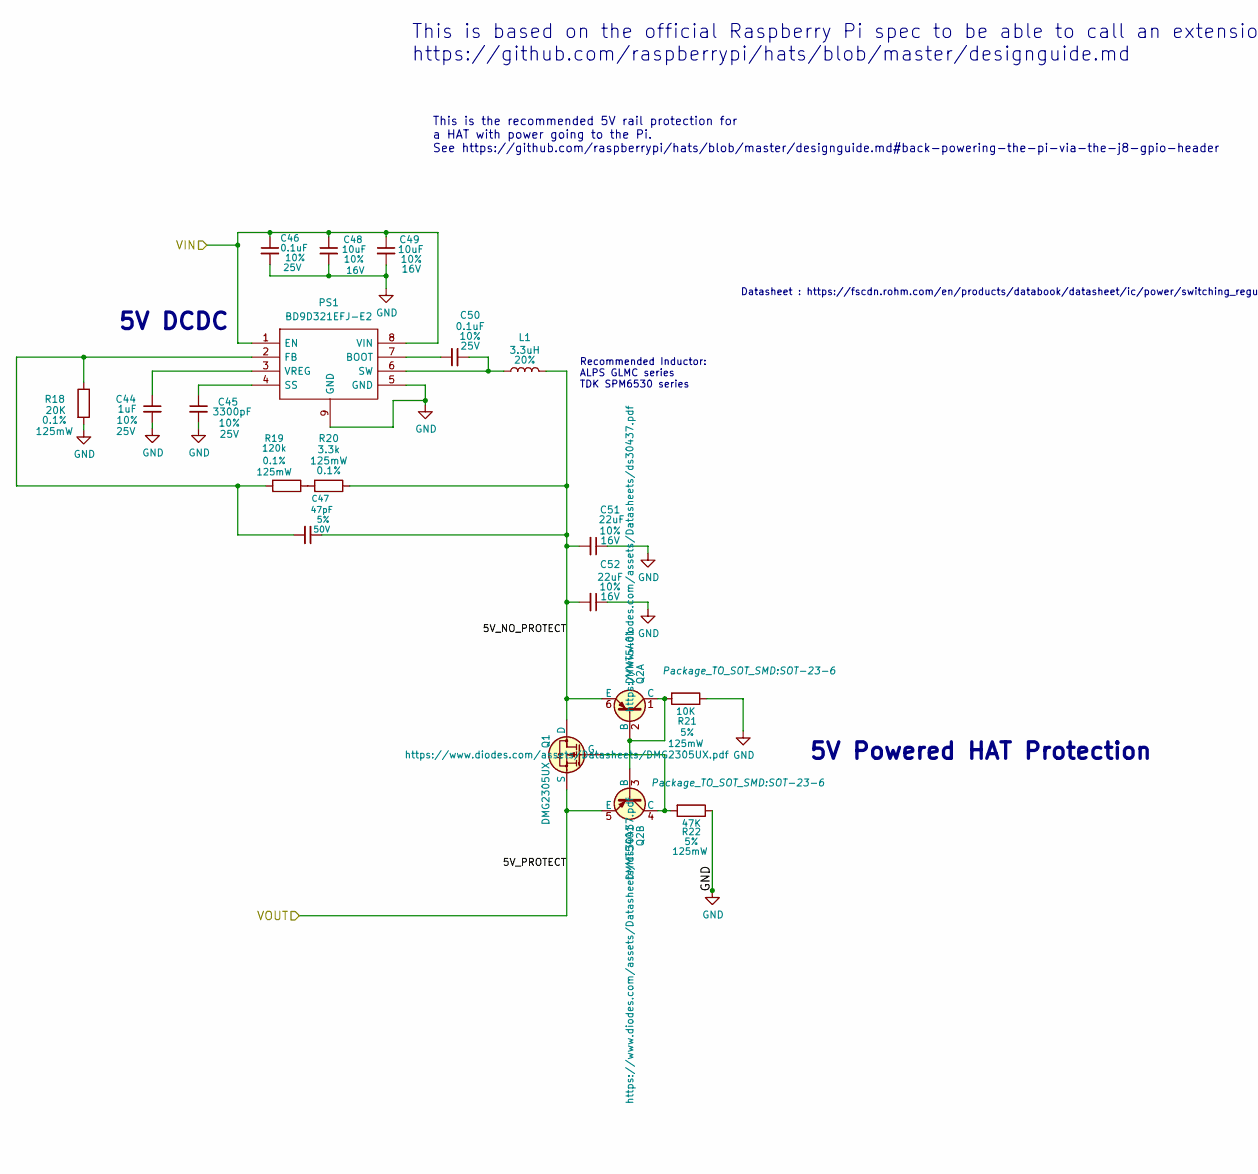
[picture p34: schematic BD9D321EFJ-E2_dcdc_5V.kicad_sch, part in row 1, column 1]

Parts:
C44: 1uF; C_0603_1608Metric_Pad1.08x0.95mm_HandSolder; Tolerance 10%; Voltage 25V
C45: 3300pF; C_0402_1005Metric_Pad0.74x0.62mm_HandSolder; Tolerance 10%; Voltage 25V
C46, C50: 0.1uF; C_0402_1005Metric_Pad0.74x0.62mm_HandSolder; Tolerance 10%; Voltage 25V
C47: 47pF; C_0805_2012Metric_Pad1.18x1.45mm_HandSolder; Tolerance 5%; Voltage 50V
C48, C49: 10uF; C_0805_2012Metric_Pad1.18x1.45mm_HandSolder; Tolerance 10%; Voltage 16V
C51, C52: 22uF; C_0805_2012Metric_Pad1.18x1.45mm_HandSolder; Tolerance 10%; Voltage 16V
L1: 3.3uH; Inductor_SPM6530T-3R3M; Tolerance 20%
PS1: BD9D321EFJ-E2; Manufacturer_Part_Number BD9D321EFJ-E2
Q1: DMG2305UX; SOT-23
Q2: DMMT5401; SOT-23-6
R18: 20K; R_0805_2012Metric_Pad1.20x1.40mm_HandSolder; Tolerance 0.1%
R19: 120k; R_0805_2012Metric_Pad1.20x1.40mm_HandSolder; Tolerance 0.1%
R20: 3.3k; R_0805_2012Metric_Pad1.20x1.40mm_HandSolder; Tolerance 0.1%
R21: 10K; R_0805_2012Metric_Pad1.20x1.40mm_HandSolder; Tolerance 5%
R22: 47K; R_0805_2012Metric_Pad1.20x1.40mm_HandSolder; Tolerance 5%

Connections:
5V_NO_PROTECT: C47.1, C51.2, C52.2, L1.2, Q1.3 (D), Q2.6 (E), R20.1
5V_PROTECT: Q1.2 (S), Q2.5 (E)
GND: C44.2, C45.2, C46.2, C48.2, C49.2, C51.1, C52.1, PS1.5 (GND), PS1.9 (GND), R18.2, R21.1, R22.1
unnamed: C44.1, PS1.3 (VREG)
unnamed: C45.1, PS1.4 (SS)
unnamed: C47.2, PS1.2 (FB), R18.1, R19.2
unnamed: C50.1, L1.1, PS1.6 (SW)
unnamed: C50.2, PS1.7 (BOOT)
unnamed: Q1.1 (G), Q2.4 (C), R22.2
unnamed: Q2.1 (C), Q2.2 (B), Q2.3 (B), R21.2
unnamed: R19.1, R20.2
VIN: C46.1, C48.1, C49.1, PS1.1 (EN), PS1.8 (VIN)

Notes on the sheet:
5V DCDC
This is the recommended 5V rail protection for a HAT with power going to the Pi. See https://github.com/raspberrypi/hats/blob/master/designguide.md#back-powering-the-pi-via-the-j8-gpio-header
Recommended Inductor: ALPS GLMC series TDK SPM6530 series
Datasheet : https://fscdn.rohm.com/en/products/databook/datasheet/ic/power/switching_regulator/bd9d321efj-e.pdf
This is based on the official Raspberry Pi spec to be able to call an extension board a HAT. https://github.com/raspberrypi/hats/blob/master/designguide.md
5V Powered HAT Protection
Ref: https://fscdn.rohm.com/en/products/databook/applinote/ic/power/switching_regulator/bd9d321efj_brd_appli-e.pdf
