ber2rv/fluidic/fluidics/DRV8841.kicad_sch

## KiCad design fluidics/DRV8841.kicad_sch (2024-05-15)

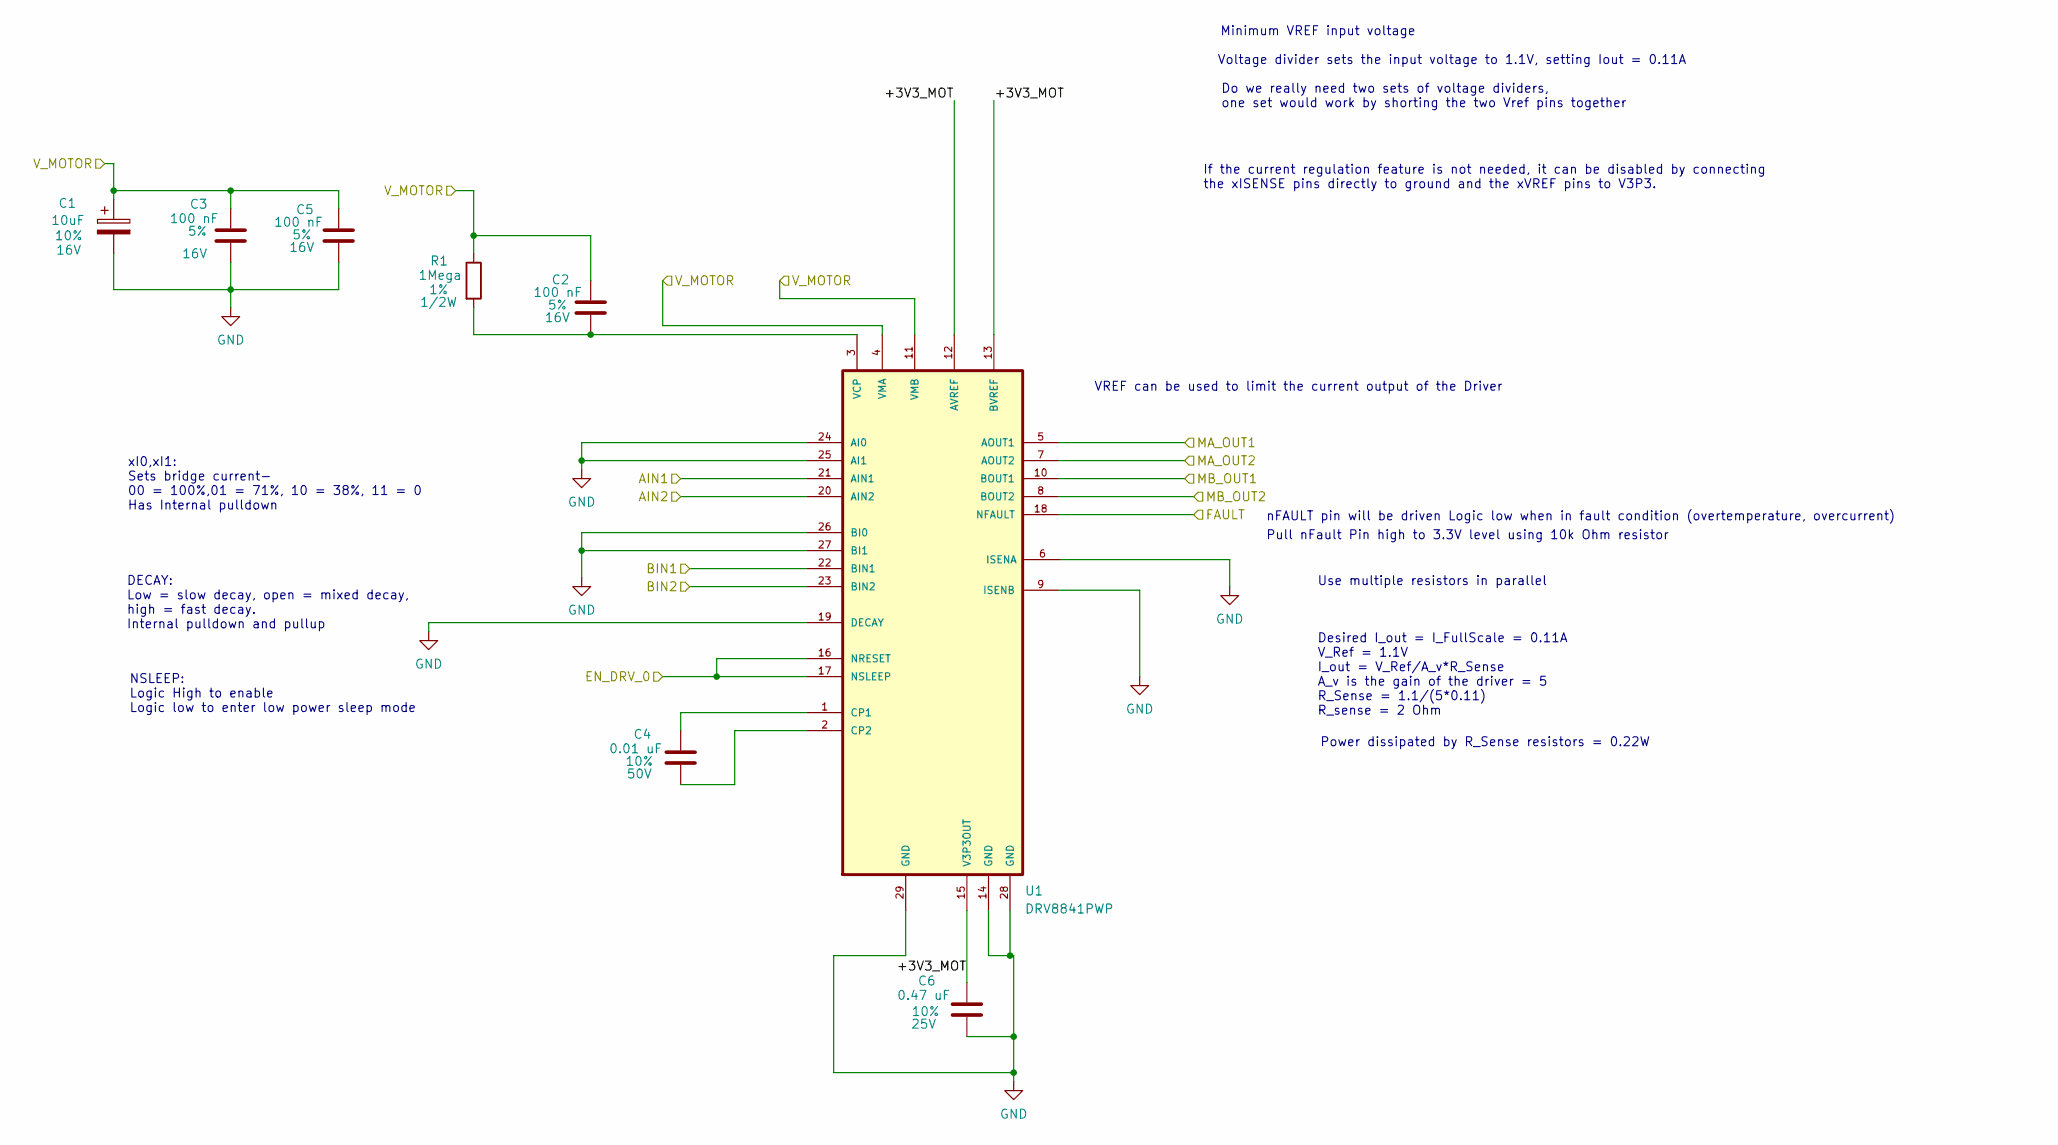
[picture p35: schematic DRV8841.kicad_sch]

Parts:
C1: 10uF; CP_EIA-2012-12_Kemet-R_Pad1.30x1.05mm_HandSolder; Voltage Rating 16 V; Tolerance 10%
C2: 100 nF; C_0402_1005Metric_Pad0.74x0.62mm_HandSolder; Voltage Rating 16V; Tolerance 5%
C3: 100 nF; C_0402_1005Metric_Pad0.74x0.62mm_HandSolder; Tolerance 5%; Voltage 16V
C4: 0.01 uF; C_0402_1005Metric_Pad0.74x0.62mm_HandSolder; Tolerance 10%; Voltage 50V
C5: 100 nF; C_0402_1005Metric_Pad0.74x0.62mm_HandSolder; Voltage Rating 15V; Tolerance 5%
C6: 0.47 uF; C_0402_1005Metric_Pad0.74x0.62mm_HandSolder; Tolerance 10%; Voltage 25V
R1: 1Mega; R_0805_2012Metric_Pad1.20x1.40mm_HandSolder; Tolerance 1%
U1: DRV8841PWP; PWP0028C_L

Connections:
+3V3_MOT: C6.2, U1.12 (AVREF), U1.13 (BVREF), U1.15 (V3P3OUT)
AIN1: U1.21 (AIN1)
AIN2: U1.20 (AIN2)
BIN1: U1.22 (BIN1)
BIN2: U1.23 (BIN2)
EN_DRV_0: U1.16 (NRESET), U1.17 (NSLEEP)
FAULT: U1.18 (NFAULT)
GND: C1.2, C3.1, C5.1, C6.1, U1.6 (ISENA), U1.9 (ISENB), U1.14 (GND), U1.19 (DECAY), U1.24 (AI0), U1.25 (AI1), U1.26 (BI0), U1.27 (BI1), U1.28 (GND), U1.29 (GND)
MA_OUT1: U1.5 (AOUT1)
MA_OUT2: U1.7 (AOUT2)
MB_OUT1: U1.10 (BOUT1)
MB_OUT2: U1.8 (BOUT2)
unnamed: C2.1, R1.2, U1.3 (VCP)
unnamed: C4.1, U1.2 (CP2)
unnamed: C4.2, U1.1 (CP1)
V_MOTOR: C1.1, C2.2, C3.2, C5.2, R1.1, U1.4 (VMA), U1.11 (VMB)

Notes on the sheet:
Do we really need two sets of voltage dividers, one set would work by shorting the two Vref pins together
xI0,xI1: Sets bridge current- 00 = 100%,01 = 71%, 10 = 38%, 11 = 0 Has Internal pulldown
Power dissipated by R_Sense resistors = 0.22W
Desired I_out = I_FullScale = 0.11A V_Ref = 1.1V I_out = V_Ref/A_v*R_Sense A_v is the gain of the driver = 5 R_Sense = 1.1/(5*0.11) R_sense = 2 Ohm
If the current regulation feature is not needed, it can be disabled by connecting the xISENSE pins directly to ground and the xVREF pins to V3P3.
NSLEEP: Logic High to enable Logic low to enter low power sleep mode
Voltage divider sets the input voltage to 1.1V, setting Iout = 0.11A
Use multiple resistors in parallel
DECAY: Low = slow decay, open = mixed decay, high = fast decay. Internal pulldown and pullup
VREF can be used to limit the current output of the Driver
nFAULT pin will be driven Logic low when in fault condition (overtemperature, overcurrent)
Minimum VREF input voltage
Pull nFault Pin high to 3.3V level using 10k Ohm resistor
