ber2rv/fluidic/fluidics/LDO_5V_3.kicad_sch

## KiCad design fluidics/LDO_5V_3.kicad_sch (2024-05-15)

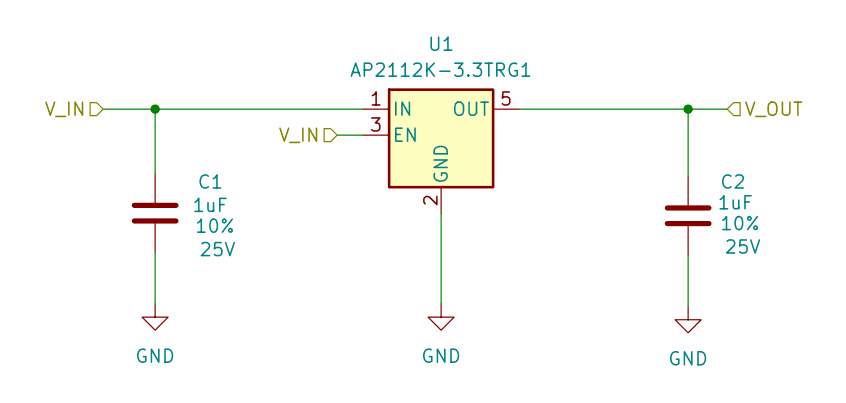
[picture p36: schematic LDO_5V_3.kicad_sch]

Parts:
C1, C2: 1uF; C_0603_1608Metric_Pad1.08x0.95mm_HandSolder; Tolerance 10%; Voltage 25V
U1: AP2112K-3.3TRG1; SOT-23-5

Connections:
GND: C1.2, C2.2, U1.2 (GND)
V_IN: C1.1, U1.1 (IN), U1.3 (EN)
V_OUT: C2.1, U1.5 (OUT)
