ber2rv/fluidic/fluidics/emi_filter_dc_dc.kicad_sch

## KiCad design fluidics/emi_filter_dc_dc.kicad_sch (2024-05-15)

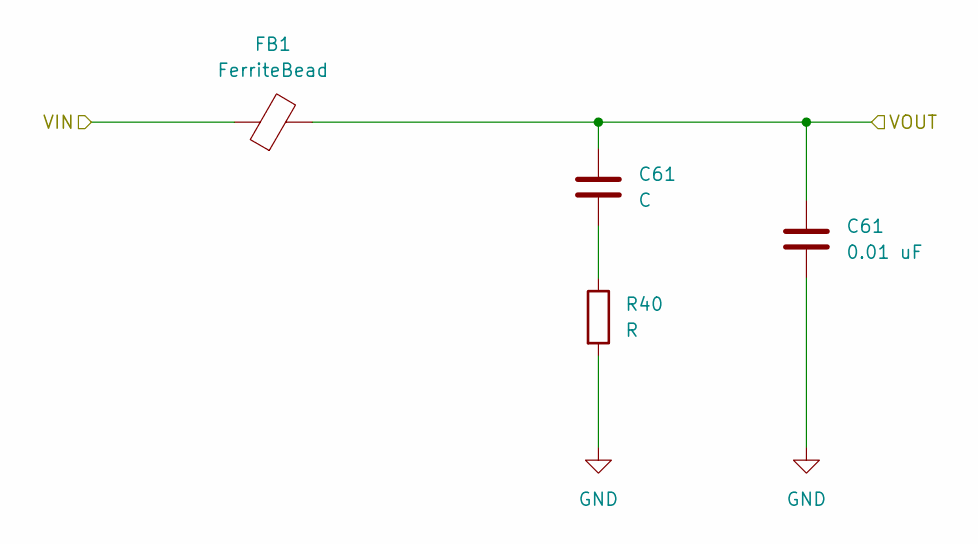
[picture p37: schematic emi_filter_dc_dc.kicad_sch]

Parts:
C61: 0.01 uF; C_0603_1608Metric_Pad1.08x0.95mm_HandSolder
FB1: FerriteBead; R_0805_2012Metric_Pad1.20x1.40mm_HandSolder
R40: R; R_0603_1608Metric_Pad0.98x0.95mm_HandSolder

Connections:
GND: C61.2, R40.2
unnamed: C61.2, R40.1
VIN: FB1.1
VOUT: C61.1, FB1.2
