ber2rv/fluidic/fluidics/fluidics.kicad_sch

## KiCad design fluidics/fluidics.kicad_sch (2024-05-15)

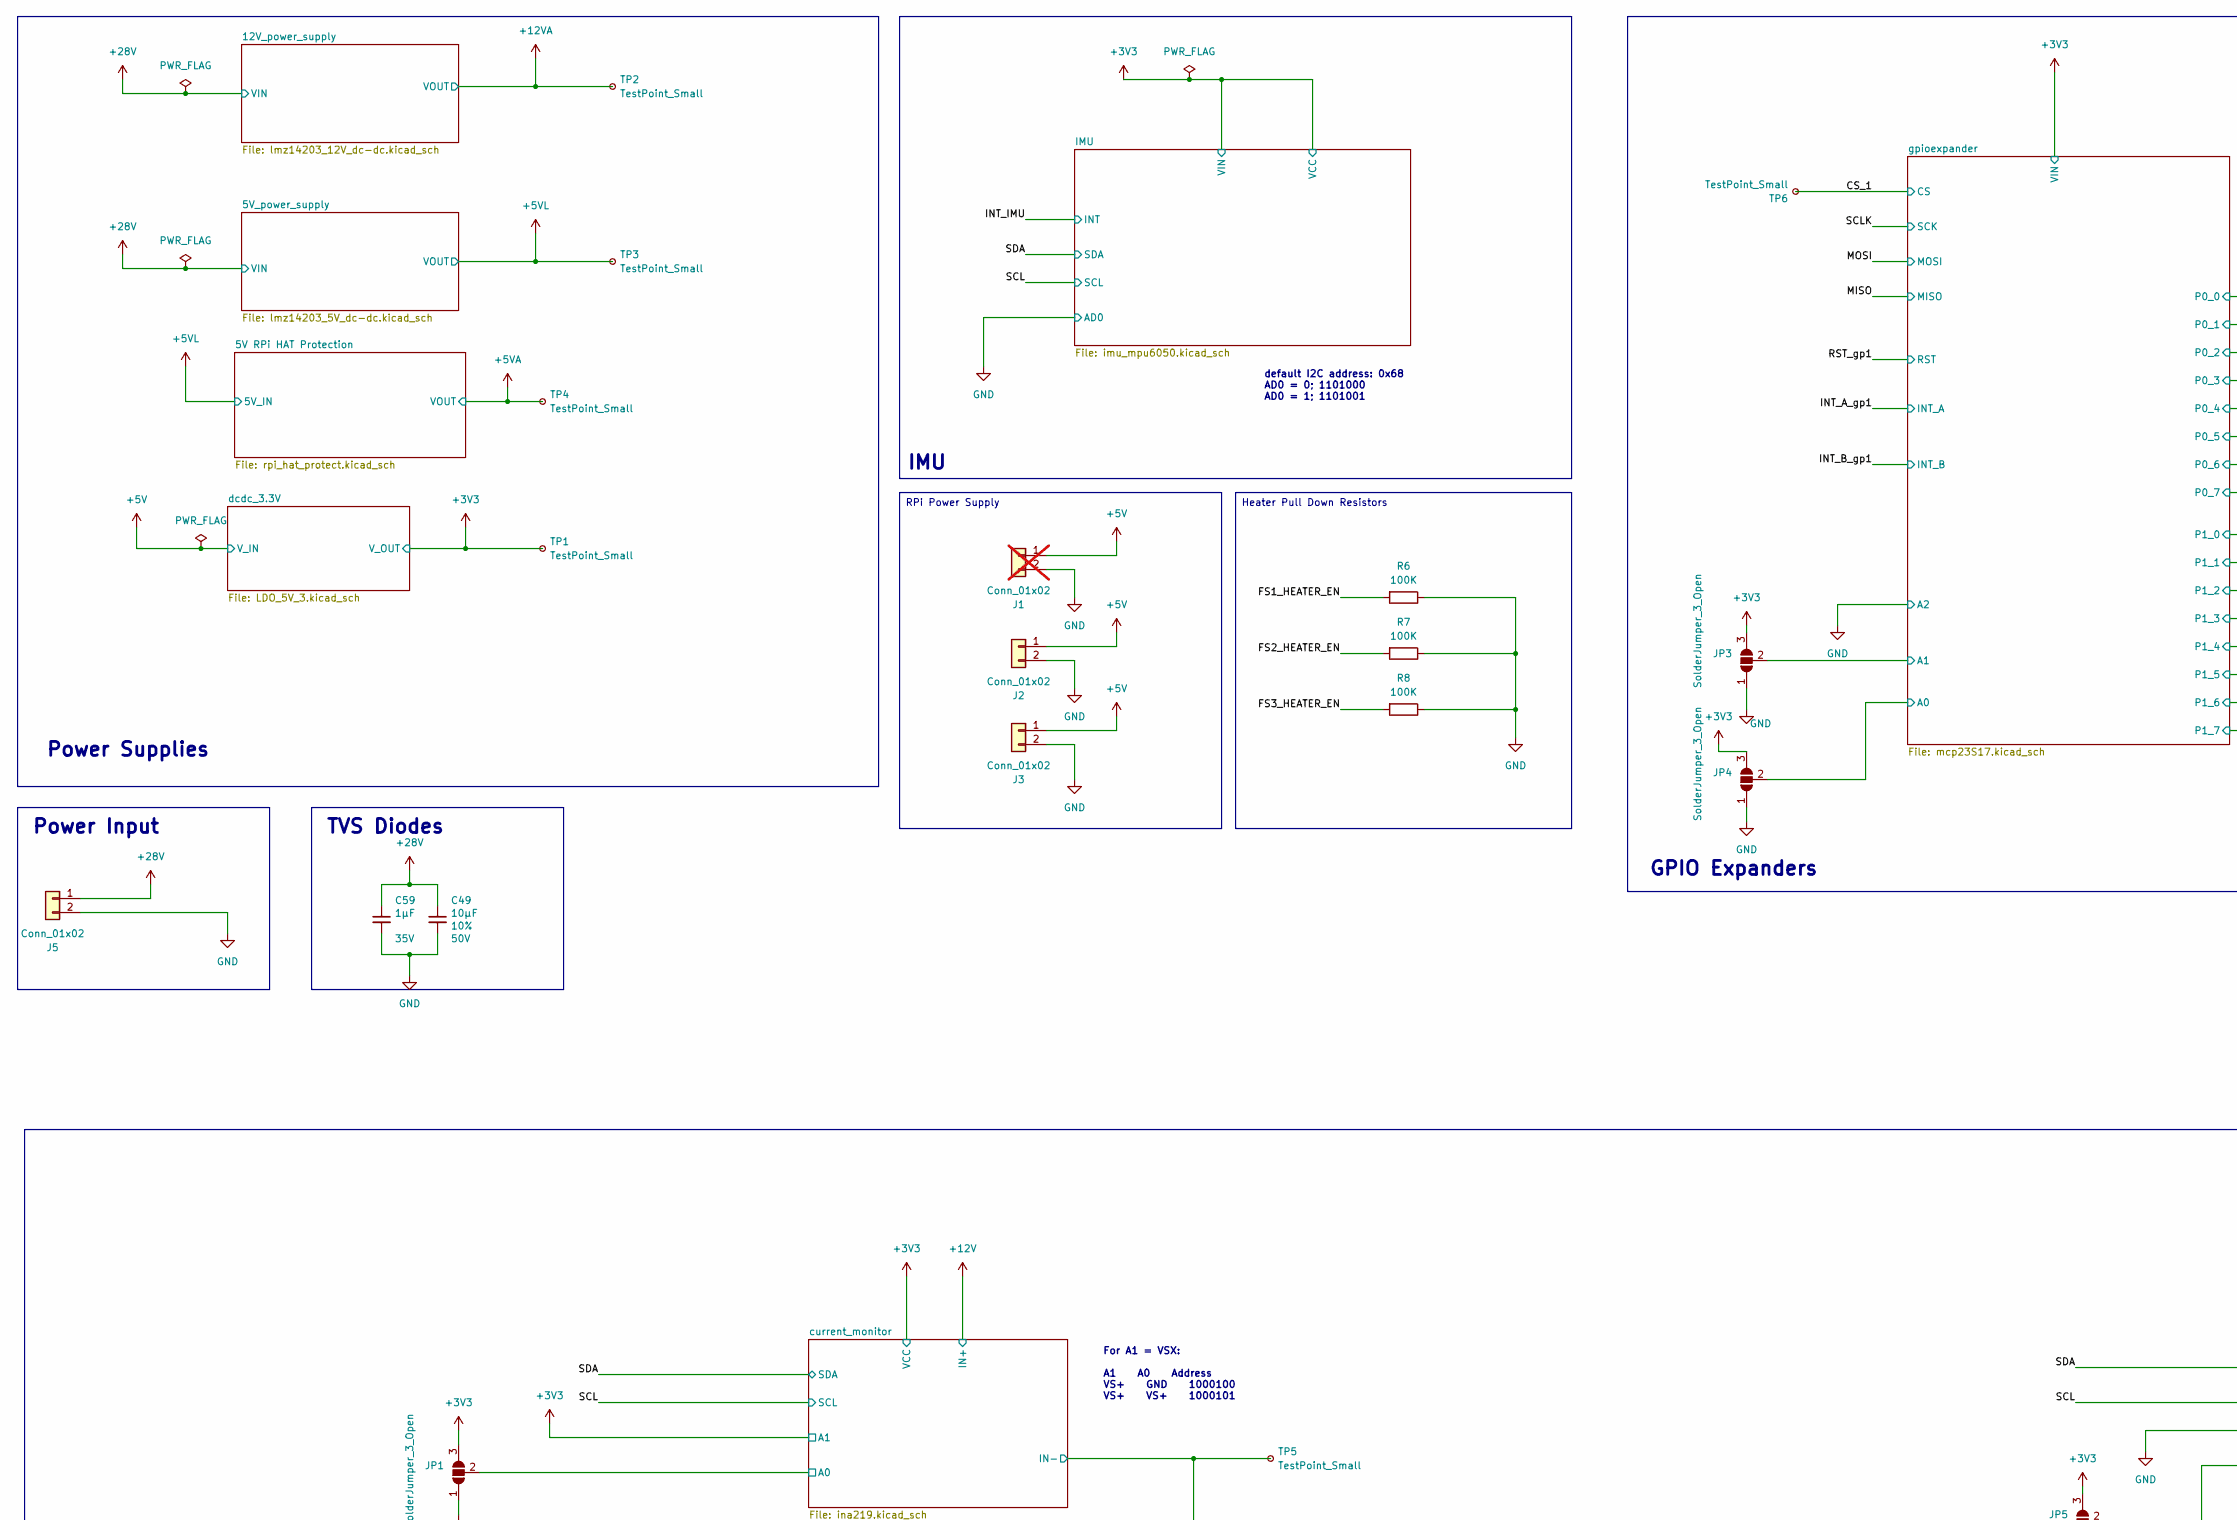
[picture p38: schematic fluidics.kicad_sch, part in row 1, column 1]

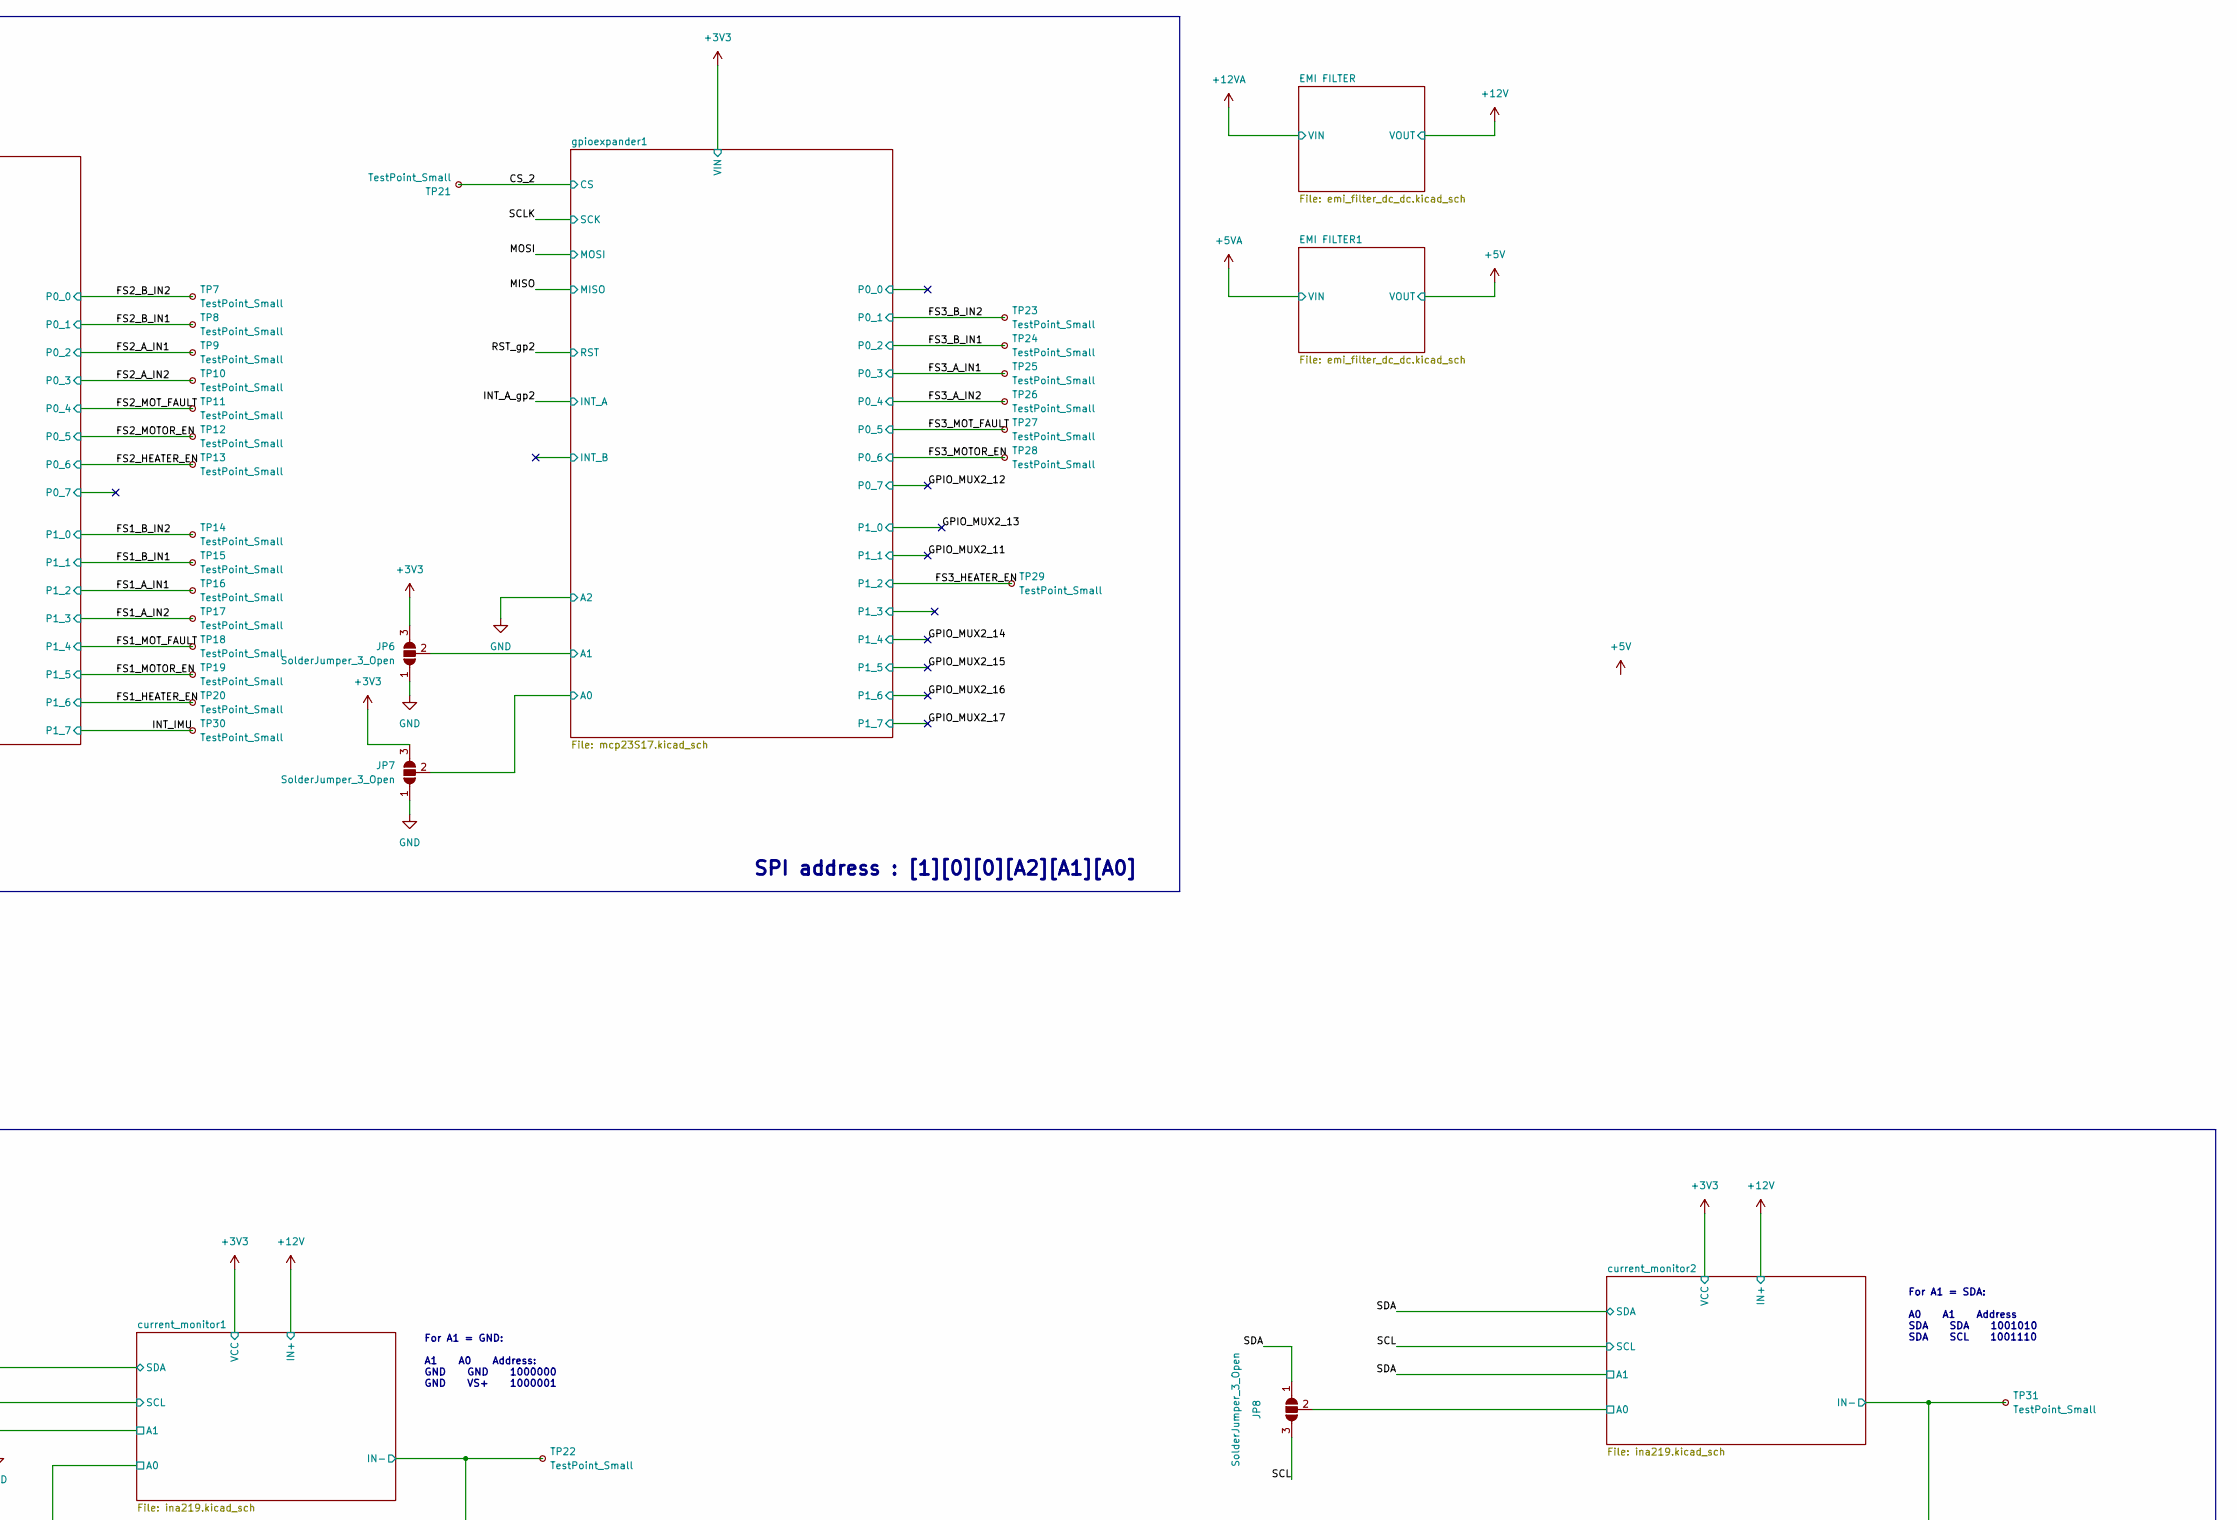
[picture p39: schematic fluidics.kicad_sch, part in row 1, column 2]

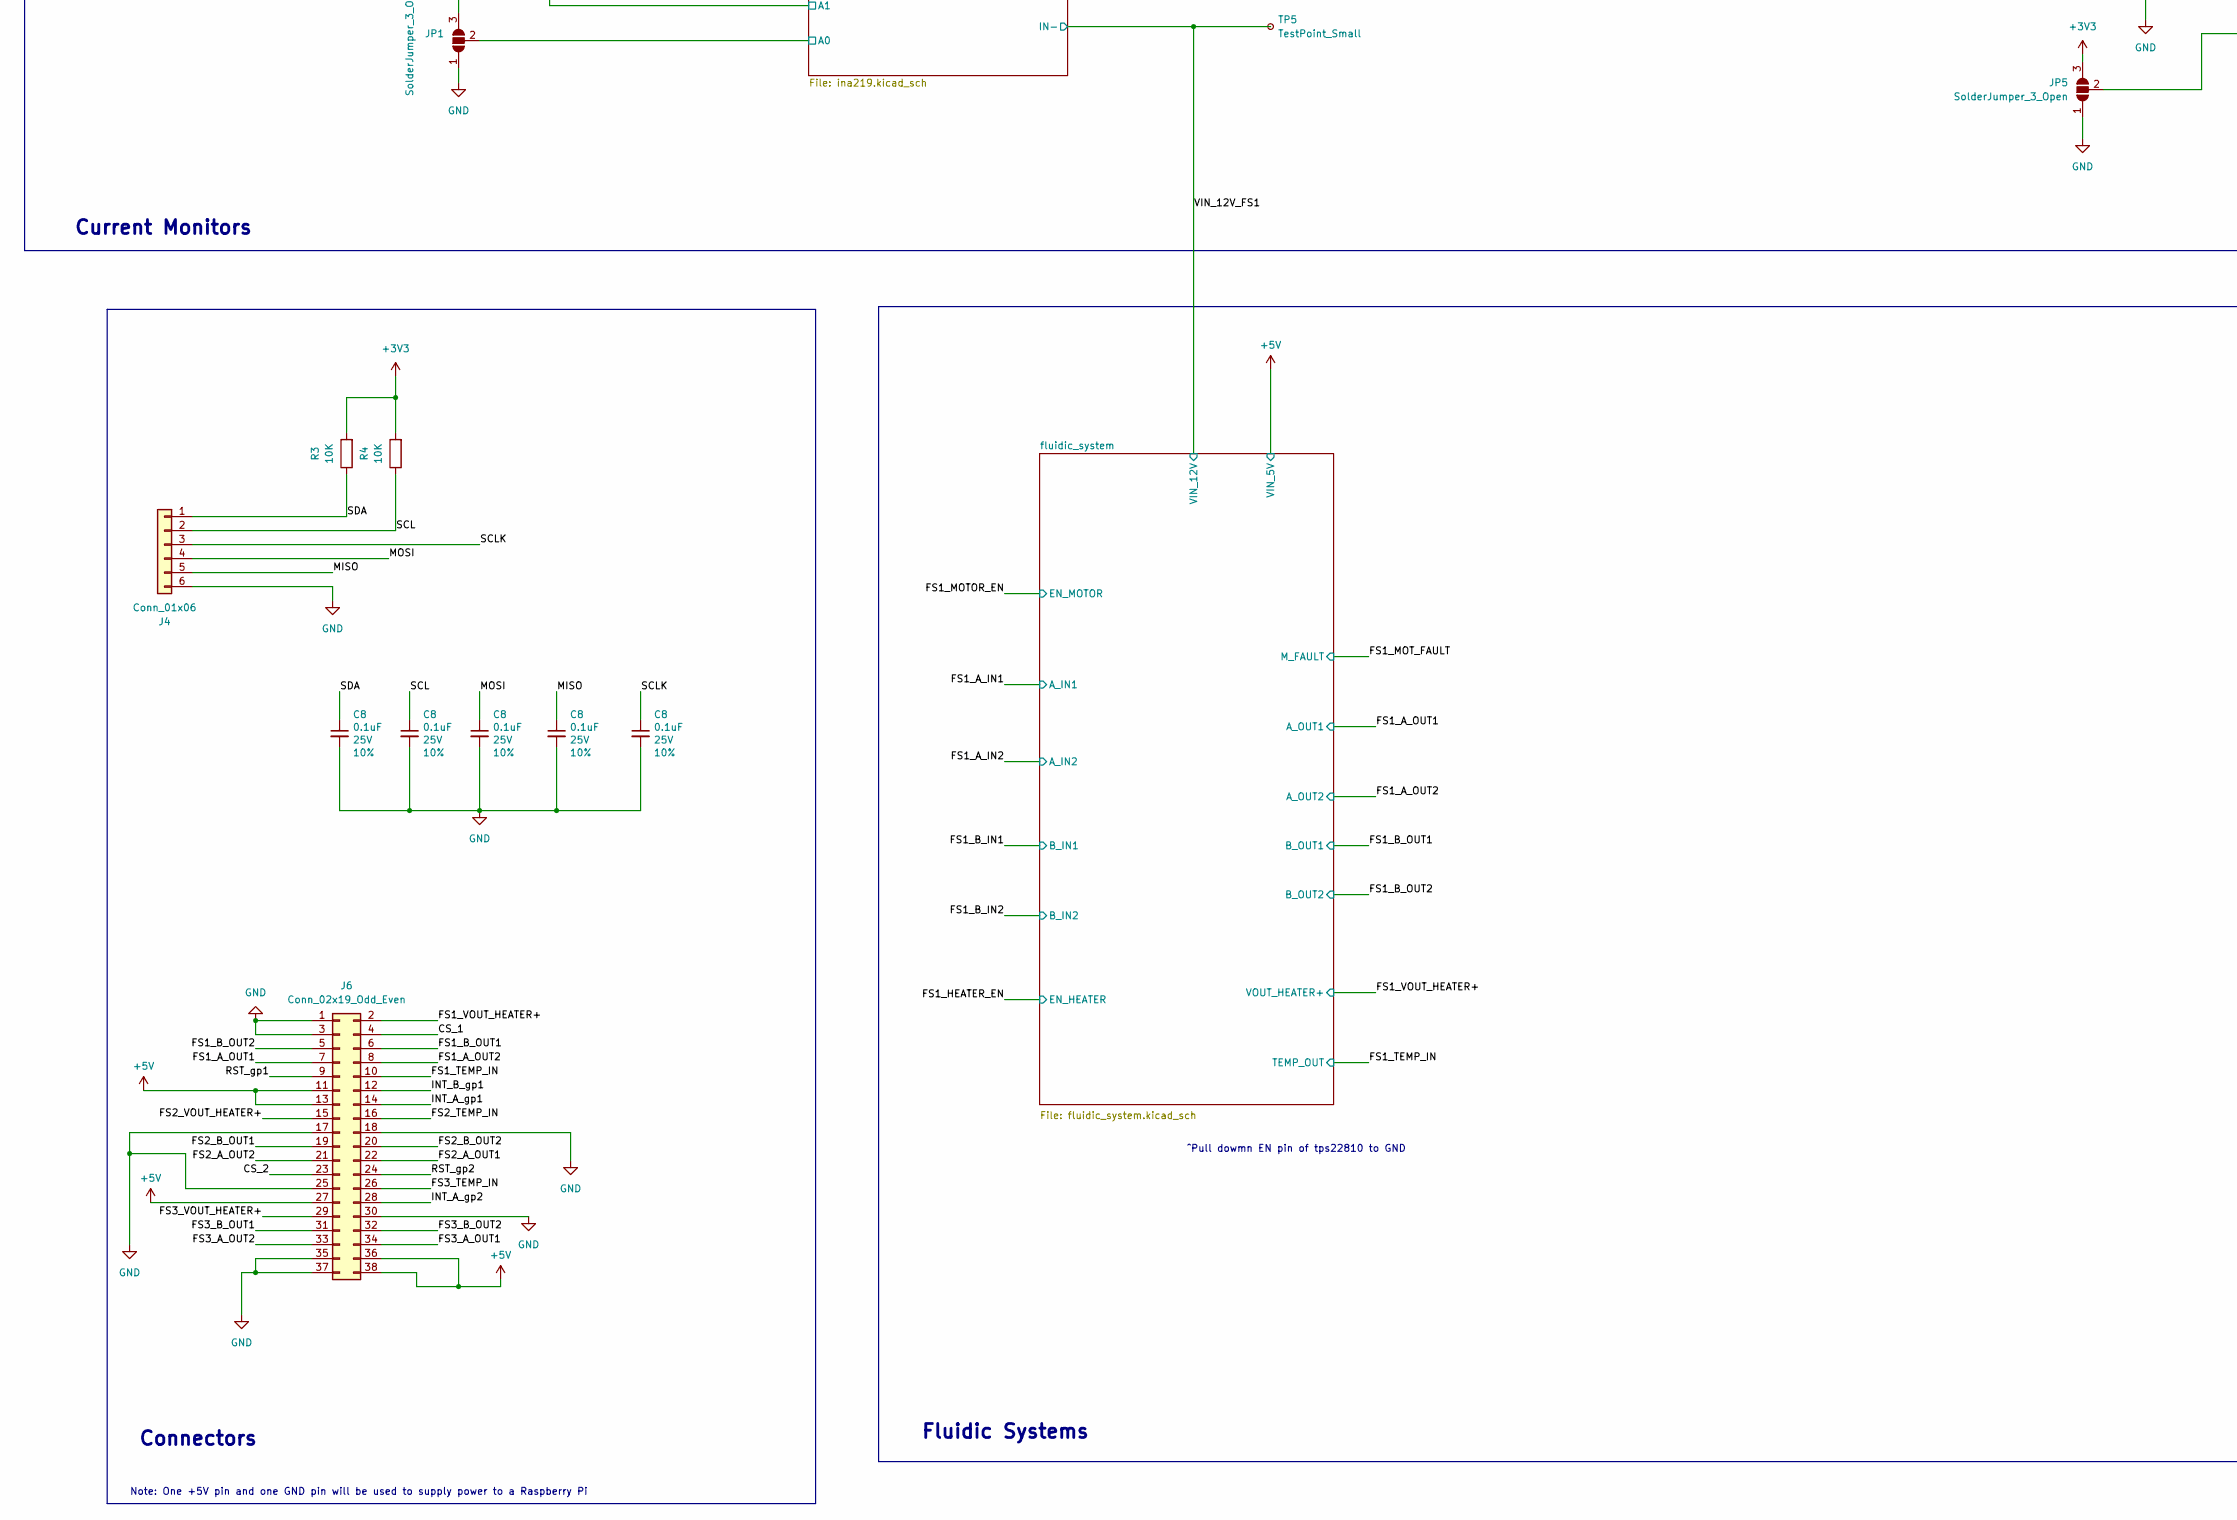
[picture p40: schematic fluidics.kicad_sch, part in row 2, column 1]

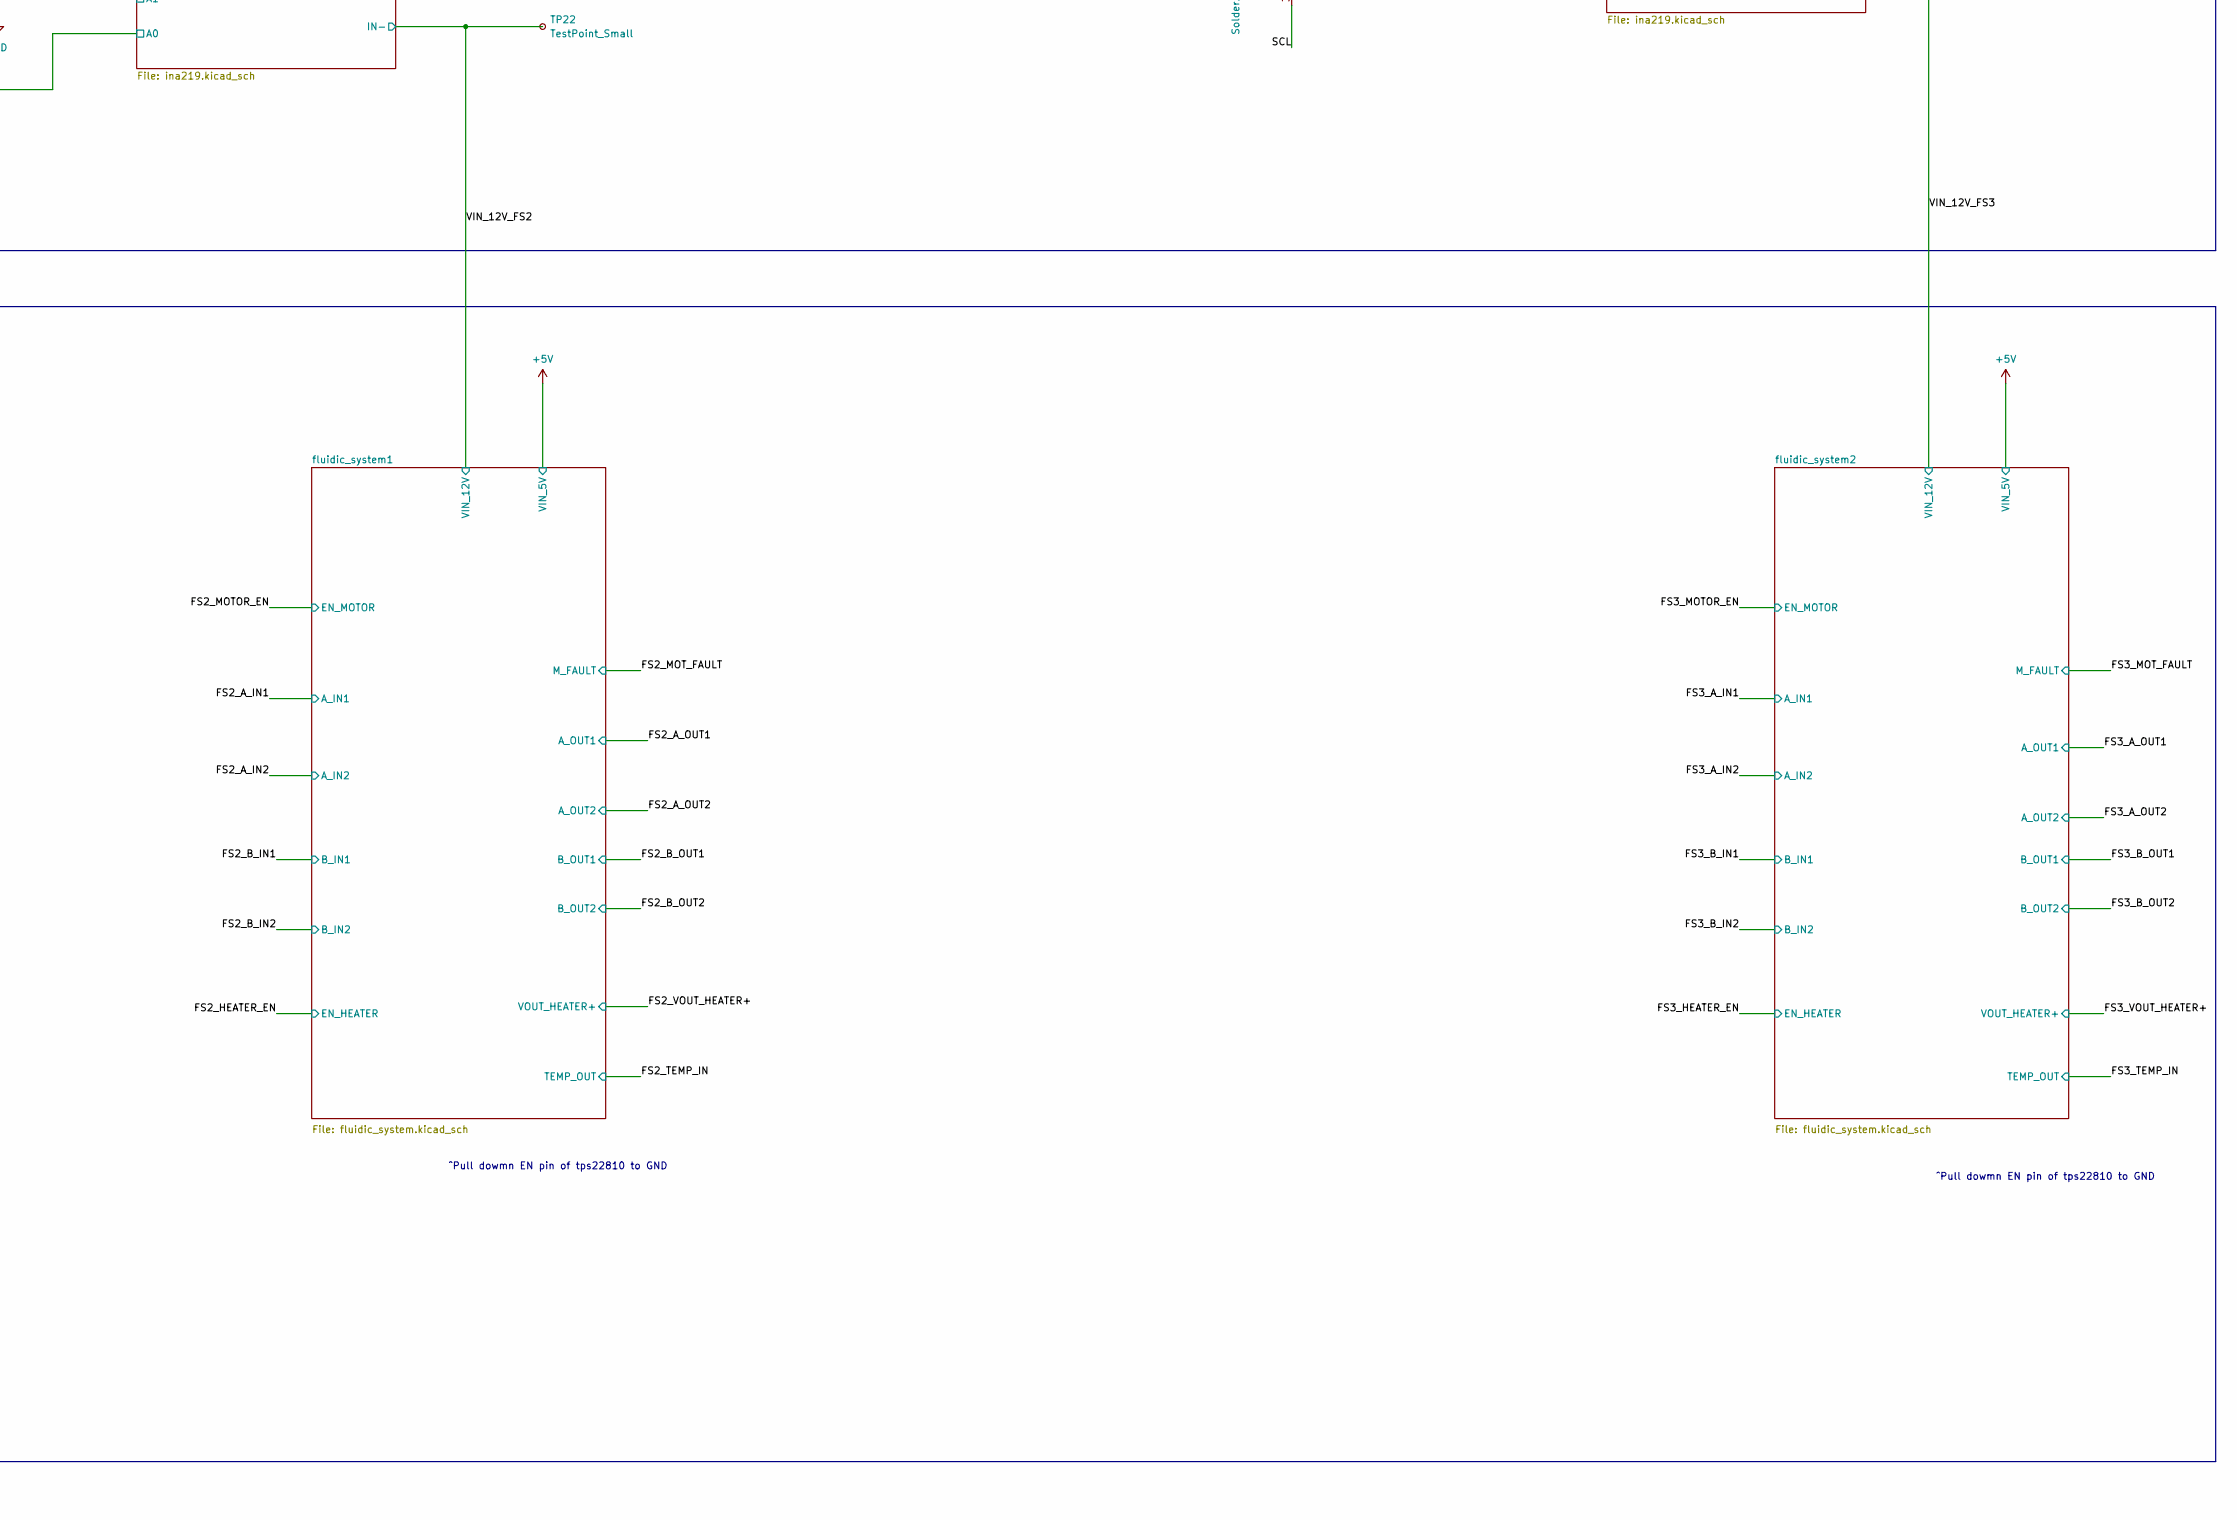
[picture p41: schematic fluidics.kicad_sch, part in row 2, column 2]

Parts:
C8: 0.1uF; C_0402_1005Metric_Pad0.74x0.62mm_HandSolder; Voltage 25V; Tolerance 10%
C49: 10µF; C_1206_3216Metric_Pad1.33x1.80mm_HandSolder; tolerance 10%; Voltage 50V
C59: 1µF; C_0603_1608Metric_Pad1.08x0.95mm_HandSolder; Voltage 35V; Tolerance 10%
J1: Conn_01x02; not fitted
J2, J3, J5: Conn_01x02; CONN_OSTVN02A150_OST
J4: Conn_01x06; CONN_OSTVN06A150_OST
J6: Conn_02x19_Odd_Even; PinHeader_2x19_P2.54mm_Vertical
JP1, JP3, JP4, JP5, JP6, JP7, JP8: SolderJumper_3_Open; SolderJumper-3_P1.3mm_Open_Pad1.0x1.5mm
R3, R4: 10K; R_0402_1005Metric_Pad0.72x0.64mm_HandSolder; Tolerance 1%
R6, R7, R8: 100K; R_0603_1608Metric_Pad0.98x0.95mm_HandSolder; Tolerance 1%
TP1, TP2, TP3, TP4, TP5, TP6, TP7, TP8, TP9, TP10, TP11, TP12, TP13, TP14, TP15, TP16, TP17, TP18, TP19, TP20, TP21, TP22, TP23, TP24, TP25, TP26, TP27, TP28, TP29, TP30, TP31: TestPoint_Small; TestPoint_Pad_D0.5mm

Connections:
+3V3: JP1.3 (B), JP3.3 (B), JP4.3 (B), JP5.3 (B), JP6.3 (B), JP7.3 (B), R3.2, R4.2, TP1.1
+5V: J1.1, J2.1, J3.1, J6.11, J6.13, J6.27, J6.36, J6.38
+5VA: TP4.1
+5VL: TP3.1
+12VA: TP2.1
+28V: C49.1, C59.1, J5.1
A0: JP1.2 (C), JP4.2 (C), JP5.2 (C), JP7.2 (C), JP8.2 (C)
A1: JP3.2 (C), JP6.2 (C)
CS_1: J6.4, TP6.1
CS_2: J6.23, TP21.1
FS1_A_IN1: TP16.1
FS1_A_IN2: TP17.1
FS1_A_OUT1: J6.7
FS1_A_OUT2: J6.8
FS1_B_IN1: TP15.1
FS1_B_IN2: TP14.1
FS1_B_OUT1: J6.6
FS1_B_OUT2: J6.5
FS1_HEATER_EN: R6.2, TP20.1
FS1_MOTOR_EN: TP19.1
FS1_MOT_FAULT: TP18.1
FS1_TEMP_IN: J6.10
FS1_VOUT_HEATER+: J6.2
FS2_A_IN1: TP9.1
FS2_A_IN2: TP10.1
FS2_A_OUT1: J6.22
FS2_A_OUT2: J6.21
FS2_B_IN1: TP8.1
FS2_B_IN2: TP7.1
FS2_B_OUT1: J6.19
FS2_B_OUT2: J6.20
FS2_HEATER_EN: R7.2, TP13.1
FS2_MOTOR_EN: TP12.1
FS2_MOT_FAULT: TP11.1
FS2_TEMP_IN: J6.16
FS2_VOUT_HEATER+: J6.15
FS3_A_IN1: TP25.1
FS3_A_IN2: TP26.1
FS3_A_OUT1: J6.34
FS3_A_OUT2: J6.33
FS3_B_IN1: TP24.1
FS3_B_IN2: TP23.1
FS3_B_OUT1: J6.31
FS3_B_OUT2: J6.32
FS3_HEATER_EN: R8.2, TP29.1
FS3_MOTOR_EN: TP28.1
FS3_MOT_FAULT: TP27.1
FS3_TEMP_IN: J6.26
FS3_VOUT_HEATER+: J6.29
GND: C8.2, C49.2, C59.2, J1.2, J2.2, J3.2, J4.6, J5.2, J6.1, J6.3, J6.17, J6.18, J6.25, J6.30, J6.35, J6.37, JP1.1 (A), JP3.1 (A), JP4.1 (A), JP5.1 (A), JP6.1 (A), JP7.1 (A), R6.1, R7.1, R8.1
INT_A_gp1: J6.14
INT_A_gp2: J6.28
INT_B_gp1: J6.12
INT_IMU: TP30.1
MISO: C8.1, J4.5
MOSI: C8.1, J4.4
RST_gp1: J6.9
RST_gp2: J6.24
SCL: C8.1, J4.2, JP8.3 (B), R4.1
SCLK: C8.1, J4.3
SDA: C8.1, J4.1, JP8.1 (A), R3.1
VIN_12V_FS1: TP5.1
VIN_12V_FS2: TP22.1
VIN_12V_FS3: TP31.1

Notes on the sheet:
RPi Power Supply
Heater Pull Down Resistors
Power Supplies
TVS Diodes
SPI address : [1][0][0][A2][A1][A0]
Connectors
default I2C address: 0x68 AD0 = 0; 1101000 AD0 = 1; 1101001
^Pull dowmn EN pin of tps22810 to GND
Fluidic Systems
For A1 = VSX: A1 A0 Address VS+ GND 1000100 VS+ VS+ 1000101
Current Monitors
Power Input
For A1 = SDA: A0 A1 Address SDA SDA 1001010 SDA SCL 1001110
Note: One +5V pin and one GND pin will be used to supply power to a Raspberry Pi
For A1 = GND: A1 A0 Address: GND GND 1000000 GND VS+ 1000001
IMU
GPIO Expanders
