ber2rv/fluidic/fluidics/imu_mpu6050.kicad_sch

## KiCad design fluidics/imu_mpu6050.kicad_sch (2024-05-15)

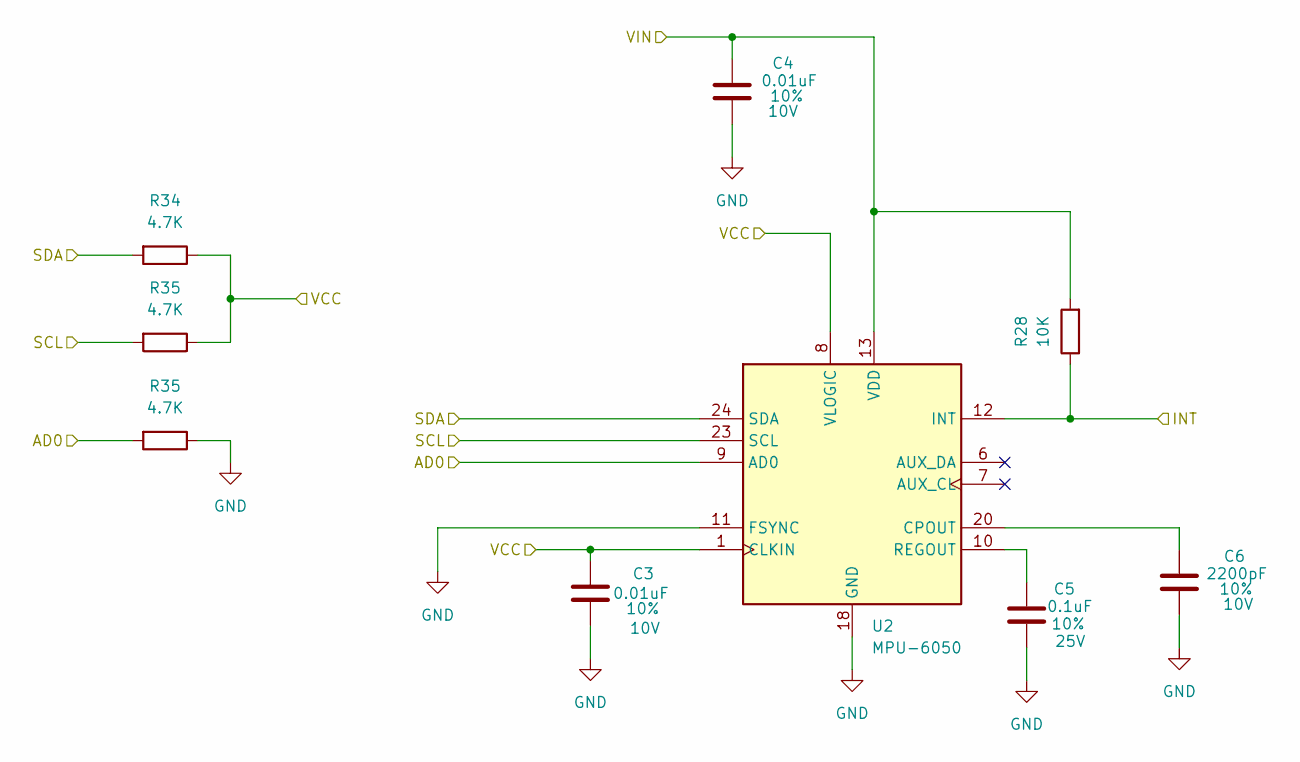
[picture p42: schematic imu_mpu6050.kicad_sch]

Parts:
C3, C4: 0.01uF; C_0402_1005Metric_Pad0.74x0.62mm_HandSolder; Tolerance 10%; Voltage 10V
C5: 0.1uF; C_0402_1005Metric_Pad0.74x0.62mm_HandSolder; Tolerance 10%; Voltage 25V
C6: 2200pF; C_0402_1005Metric_Pad0.74x0.62mm_HandSolder; Tolerance 10%; Voltage 10V
R28: 10K; R_0402_1005Metric_Pad0.72x0.64mm_HandSolder; Tolerance 1%
R34, R35: 4.7K; R_0402_1005Metric_Pad0.72x0.64mm_HandSolder; Tolerance 1%
U2: MPU-6050; InvenSense_QFN-24_4x4mm_P0.5mm

Connections:
AD0: R35.2, U2.9 (AD0)
GND: C3.2, C4.2, C5.2, C6.2, R35.1, U2.11 (FSYNC), U2.18 (GND)
INT: R28.1, U2.12 (INT)
unnamed: C5.1, U2.10 (REGOUT)
unnamed: C6.1, U2.20 (CPOUT)
SCL: R35.2, U2.23 (SCL)
SDA: R34.2, U2.24 (SDA)
VCC: C3.1, R34.1, R35.1, U2.1 (CLKIN), U2.8 (VLOGIC)
VIN: C4.1, R28.2, U2.13 (VDD)
