ber2rv/fluidic/fluidics/ina219.kicad_sch

## KiCad design fluidics/ina219.kicad_sch (2024-05-15)

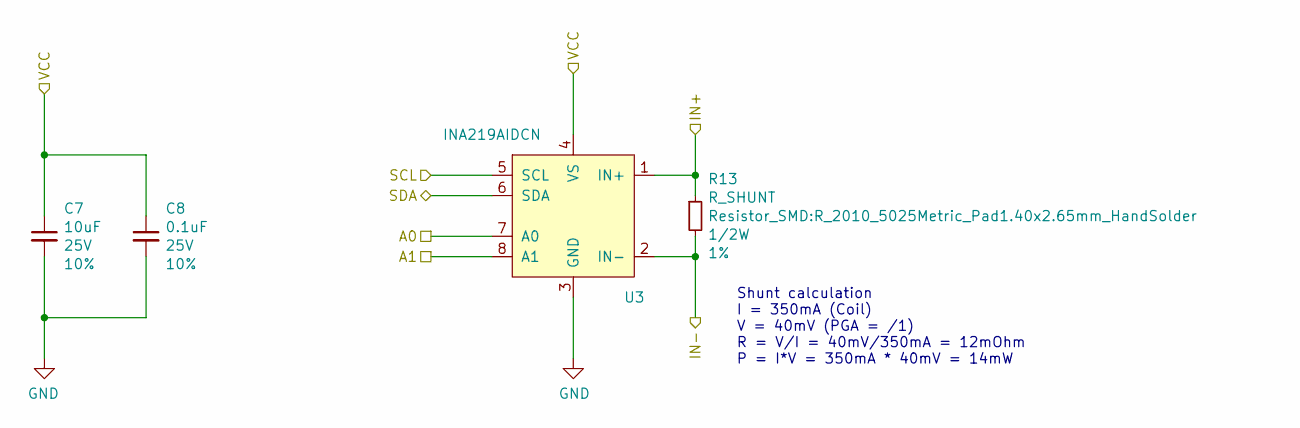
[picture p43: schematic ina219.kicad_sch]

Parts:
C7: 10uF; C_0603_1608Metric_Pad1.08x0.95mm_HandSolder; Voltage 25V; Tolerance 10%
C8: 0.1uF; C_0402_1005Metric_Pad0.74x0.62mm_HandSolder; Voltage 25V; Tolerance 10%
R13: R_SHUNT; R_2010_5025Metric_Pad1.40x2.65mm_HandSolder; Tolerance 1%
U3: INA219AIDCN; INA219

Connections:
A0: U3.7 (A0)
A1: U3.8 (A1)
GND: C7.2, C8.2, U3.3 (GND)
IN+: R13.1, U3.1 (IN+)
IN-: R13.2, U3.2 (IN-)
SCL: U3.5 (SCL)
SDA: U3.6 (SDA)
VCC: C7.1, C8.1, U3.4 (VS)

Notes on the sheet:
Shunt calculation I = 350mA (Coil) V = 40mV (PGA = /1) R = V/I = 40mV/350mA = 12mOhm P = I*V = 350mA * 40mV = 14mW
