ber2rv/fluidic/fluidics/lmz14203_5V_dc-dc.kicad_sch

## KiCad design fluidics/lmz14203_5V_dc-dc.kicad_sch (2024-05-15)

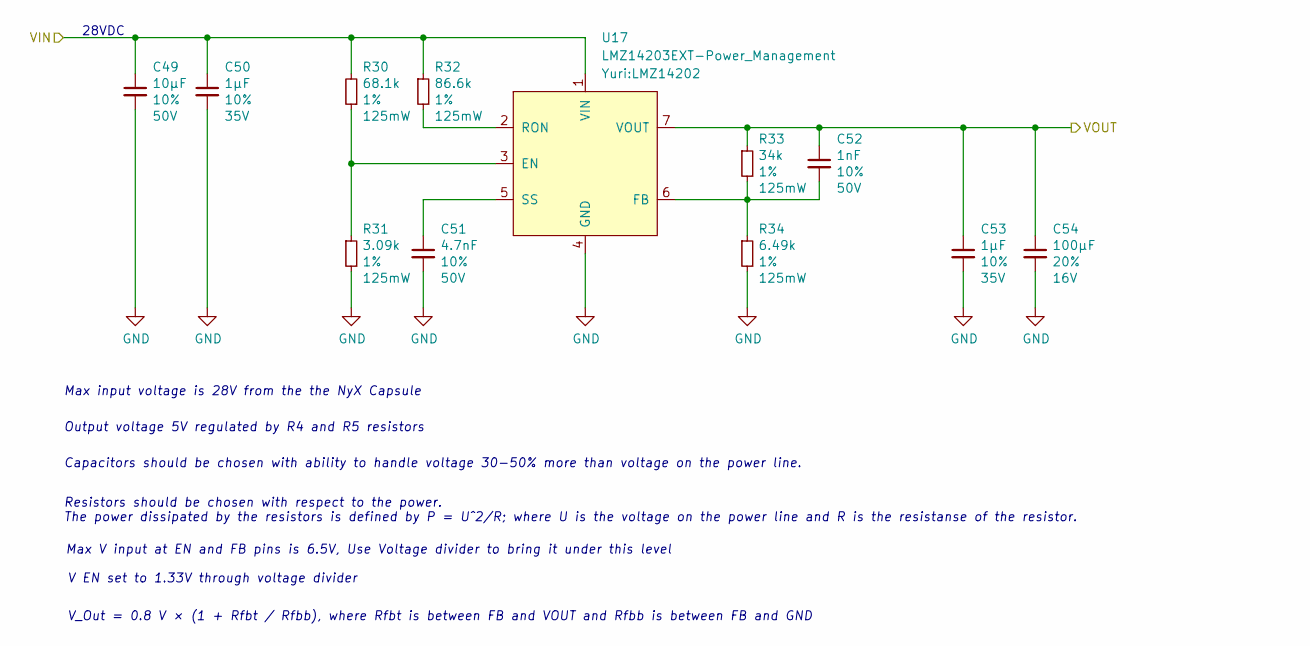
[picture p44: schematic lmz14203_5V_dc-dc.kicad_sch]

Parts:
C49: 10µF; C_1206_3216Metric_Pad1.33x1.80mm_HandSolder; tolerance 10%; Voltage 50V
C50, C53: 1µF; C_0603_1608Metric; tolerance 10%; Voltage 35V
C51: 4.7nF; C_0603_1608Metric; tolerance 10%; Voltage 50V
C52: 1nF; C_0603_1608Metric; tolerance 10%; Voltage 50V
C54: 100µF; C_1210_3225Metric_Pad1.33x2.70mm_HandSolder; tolerance 20%; Voltage 16V
R30: 68.1k; R_0603_1608Metric; tolerance 1%
R31: 3.09k; R_0603_1608Metric; tolerance 1%
R32: 86.6k; R_0603_1608Metric; tolerance 1%
R33: 34k; R_0603_1608Metric; tolerance 1%
R34: 6.49k; R_0603_1608Metric; tolerance 1%
U17: LMZ14203EXT-Power_Management; LMZ14202

Connections:
GND: C49.2, C50.2, C51.2, C53.2, C54.2, R31.2, R34.2, U17.4 (GND), U17.8 (EP)
unnamed: C51.1, U17.5 (SS)
unnamed: C52.2, R33.2, R34.1, U17.6 (FB)
unnamed: R30.1, R31.1, U17.3 (EN)
unnamed: R32.2, U17.2 (RON)
VIN: C49.1, C50.1, R30.2, R32.1, U17.1 (VIN)
VOUT: C52.1, C53.1, C54.1, R33.1, U17.7 (VOUT)

Notes on the sheet:
Resistors should be chosen with respect to the power. The power dissipated by the resistors is defined by P = U^2/R; where U is the voltage on the power line and R is the resistanse of the resistor.
28VDC
Max input voltage is 28V from the the NyX Capsule
Capacitors should be chosen with ability to handle voltage 30-50% more than voltage on the power line.
Max V input at EN and FB pins is 6.5V, Use Voltage divider to bring it under this level
V_Out = 0.8 V × (1 + Rfbt / Rfbb), where Rfbt is between FB and VOUT and Rfbb is between FB and GND
V EN set to 1.33V through voltage divider
Output voltage 5V regulated by R4 and R5 resistors
