ber2rv/fluidic/fluidics/lmz14203_12V_dc-dc.kicad_sch

## KiCad design fluidics/lmz14203_12V_dc-dc.kicad_sch (2024-05-15)

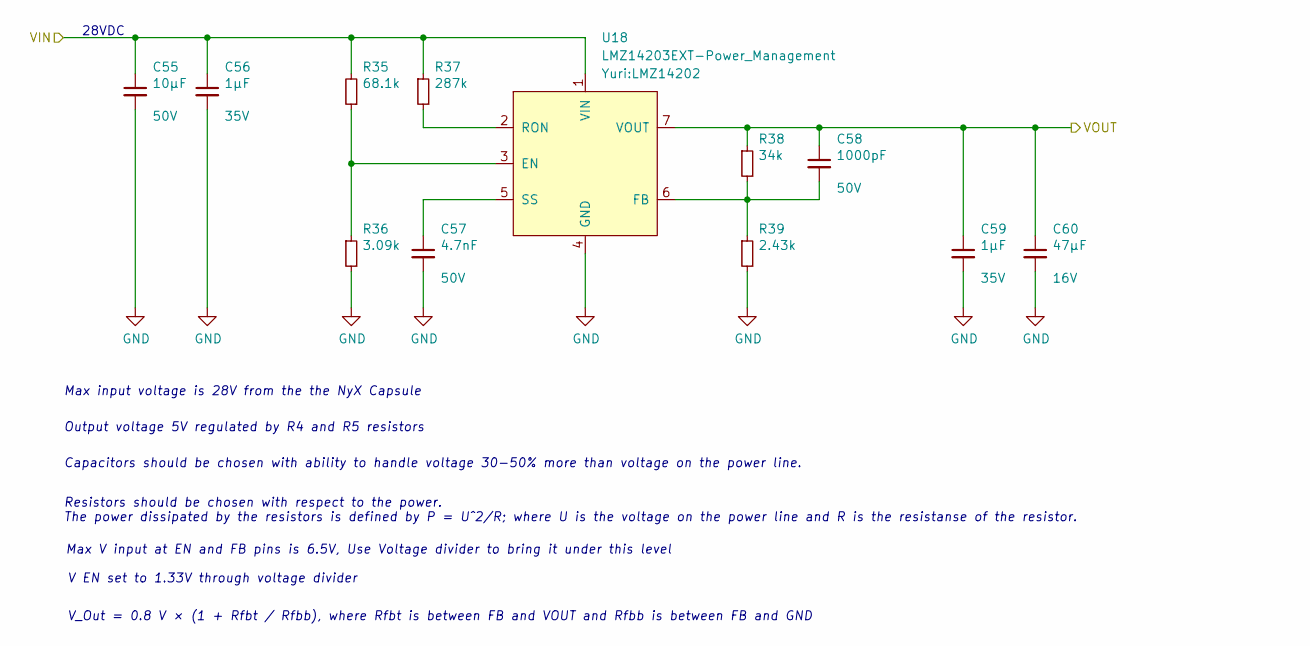
[picture p45: schematic lmz14203_12V_dc-dc.kicad_sch]

Parts:
C55: 10µF; C_1206_3216Metric_Pad1.33x1.80mm_HandSolder; Voltage 50V; Tolerance 10%
C56, C59: 1µF; C_0603_1608Metric_Pad1.08x0.95mm_HandSolder; Voltage 35V; Tolerance 10%
C57: 4.7nF; C_0402_1005Metric_Pad0.74x0.62mm_HandSolder; Voltage 50V; Tolerance 10%
C58: 1000pF; C_0402_1005Metric_Pad0.74x0.62mm_HandSolder; Voltage 50V; Tolerance 10%
C60: 47µF; C_1210_3225Metric_Pad1.33x2.70mm_HandSolder; Voltage 16V; Tolerance 10%
R35: 68.1k; R_0603_1608Metric_Pad0.98x0.95mm_HandSolder; Tolerance 1%
R36: 3.09k; R_0603_1608Metric_Pad0.98x0.95mm_HandSolder; Tolerance 1%
R37: 287k; R_0603_1608Metric_Pad0.98x0.95mm_HandSolder; Tolerance 1%
R38: 34k; R_0603_1608Metric_Pad0.98x0.95mm_HandSolder; Tolerance 1%
R39: 2.43k; R_0603_1608Metric_Pad0.98x0.95mm_HandSolder; Tolerance 0.5%
U18: LMZ14203EXT-Power_Management; LMZ14202

Connections:
GND: C55.2, C56.2, C57.2, C59.2, C60.2, R36.2, R39.2, U18.4 (GND), U18.8 (EP)
unnamed: C57.1, U18.5 (SS)
unnamed: C58.2, R38.2, R39.1, U18.6 (FB)
unnamed: R35.1, R36.1, U18.3 (EN)
unnamed: R37.2, U18.2 (RON)
VIN: C55.1, C56.1, R35.2, R37.1, U18.1 (VIN)
VOUT: C58.1, C59.1, C60.1, R38.1, U18.7 (VOUT)

Notes on the sheet:
28VDC
Capacitors should be chosen with ability to handle voltage 30-50% more than voltage on the power line.
Max V input at EN and FB pins is 6.5V, Use Voltage divider to bring it under this level
V_Out = 0.8 V × (1 + Rfbt / Rfbb), where Rfbt is between FB and VOUT and Rfbb is between FB and GND
Max input voltage is 28V from the the NyX Capsule
Resistors should be chosen with respect to the power. The power dissipated by the resistors is defined by P = U^2/R; where U is the voltage on the power line and R is the resistanse of the resistor.
V EN set to 1.33V through voltage divider
Output voltage 5V regulated by R4 and R5 resistors
