ber2rv/fluidic/fluidics/mcp23S17.kicad_sch

## KiCad design fluidics/mcp23S17.kicad_sch (2024-05-15)

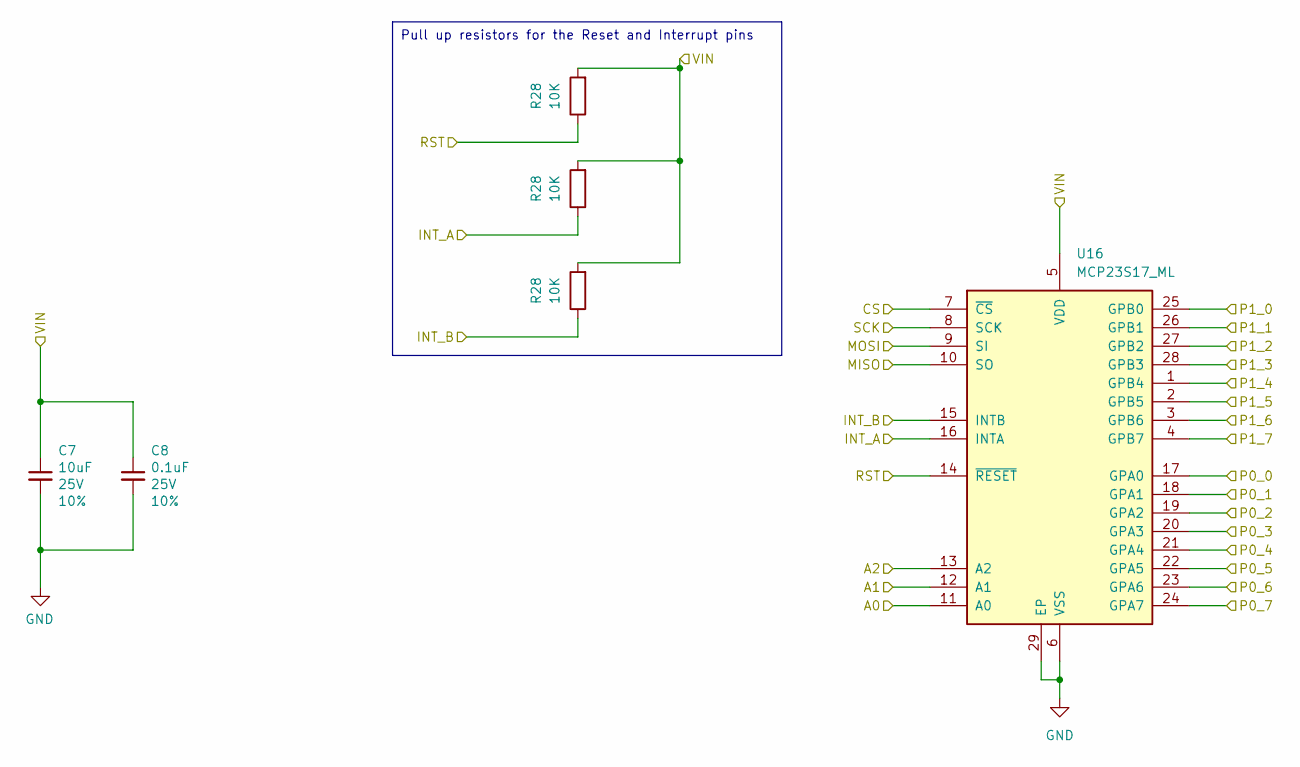
[picture p46: schematic mcp23S17.kicad_sch]

Parts:
C7: 10uF; C_0603_1608Metric_Pad1.08x0.95mm_HandSolder; Voltage 25V; Tolerance 10%
C8: 0.1uF; C_0402_1005Metric_Pad0.74x0.62mm_HandSolder; Voltage 25V; Tolerance 10%
R28: 10K; R_0402_1005Metric_Pad0.72x0.64mm_HandSolder; Tolerance 1%
U16: MCP23S17_ML; MCP23S17_ML_QFN-28

Connections:
A0: U16.11 (A0)
A1: U16.12 (A1)
A2: U16.13 (A2)
CS: U16.7 (~CS)
GND: C7.2, C8.2, U16.6 (VSS), U16.29 (EP)
INT_A: R28.1, U16.16 (INTA)
INT_B: R28.1, U16.15 (INTB)
MISO: U16.10 (SO)
MOSI: U16.9 (SI)
P0_0: U16.17 (GPA0)
P0_1: U16.18 (GPA1)
P0_2: U16.19 (GPA2)
P0_3: U16.20 (GPA3)
P0_4: U16.21 (GPA4)
P0_5: U16.22 (GPA5)
P0_6: U16.23 (GPA6)
P0_7: U16.24 (GPA7)
P1_0: U16.25 (GPB0)
P1_1: U16.26 (GPB1)
P1_2: U16.27 (GPB2)
P1_3: U16.28 (GPB3)
P1_4: U16.1 (GPB4)
P1_5: U16.2 (GPB5)
P1_6: U16.3 (GPB6)
P1_7: U16.4 (GPB7)
RST: R28.1, U16.14 (~RESET)
SCK: U16.8 (SCK)
VIN: C7.1, C8.1, R28.2, U16.5 (VDD)

Notes on the sheet:
Pull up resistors for the Reset and Interrupt pins
