ber2rv/fluidic/fluidics/rpi_hat_protect.kicad_sch

## KiCad design fluidics/rpi_hat_protect.kicad_sch (2024-05-15)

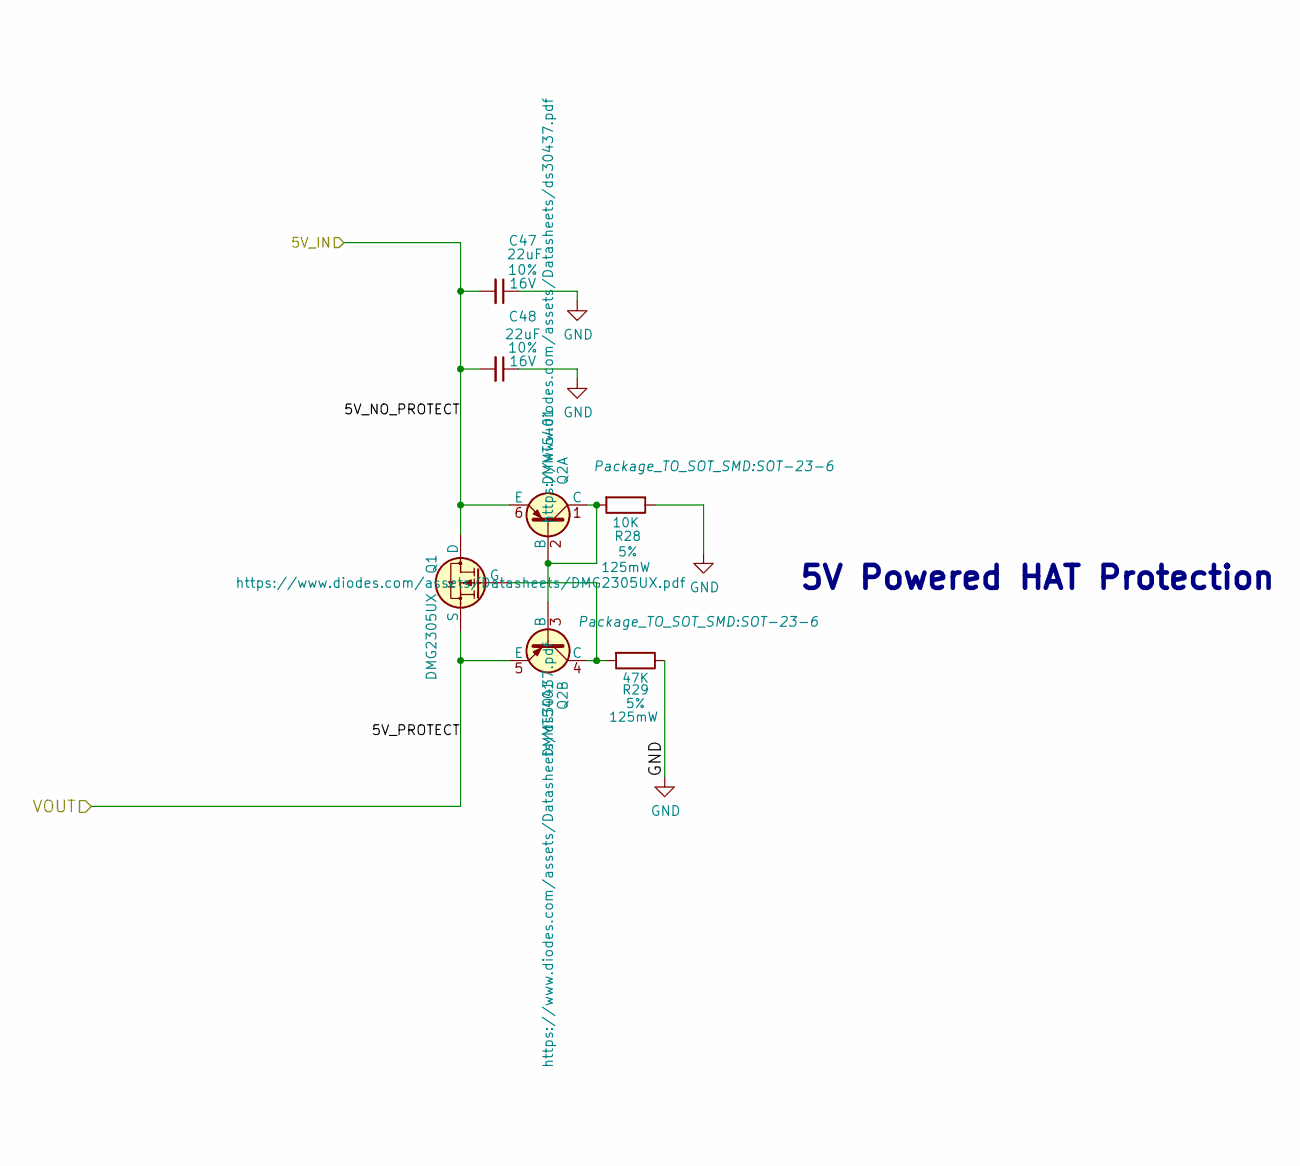
[picture p47: schematic rpi_hat_protect.kicad_sch]

Parts:
C47, C48: 22uF; C_0805_2012Metric_Pad1.18x1.45mm_HandSolder; Tolerance 10%; Voltage 16V
Q1: DMG2305UX; SOT-23
Q2: DMMT5401; SOT-23-6
R28: 10K; R_0805_2012Metric_Pad1.20x1.40mm_HandSolder; Tolerance 5%
R29: 47K; R_0805_2012Metric_Pad1.20x1.40mm_HandSolder; Tolerance 5%

Connections:
5V_IN: C47.2, C48.2, Q1.3 (D), Q2.6 (E)
5V_PROTECT: Q1.2 (S), Q2.5 (E)
GND: C47.1, C48.1, R28.1, R29.1
unnamed: Q1.1 (G), Q2.4 (C), R29.2
unnamed: Q2.1 (C), Q2.2 (B), Q2.3 (B), R28.2

Notes on the sheet:
5V Powered HAT Protection
