ber2rv/fluidic/fluidics/tps22810.kicad_sch

## KiCad design fluidics/tps22810.kicad_sch (2024-05-15)

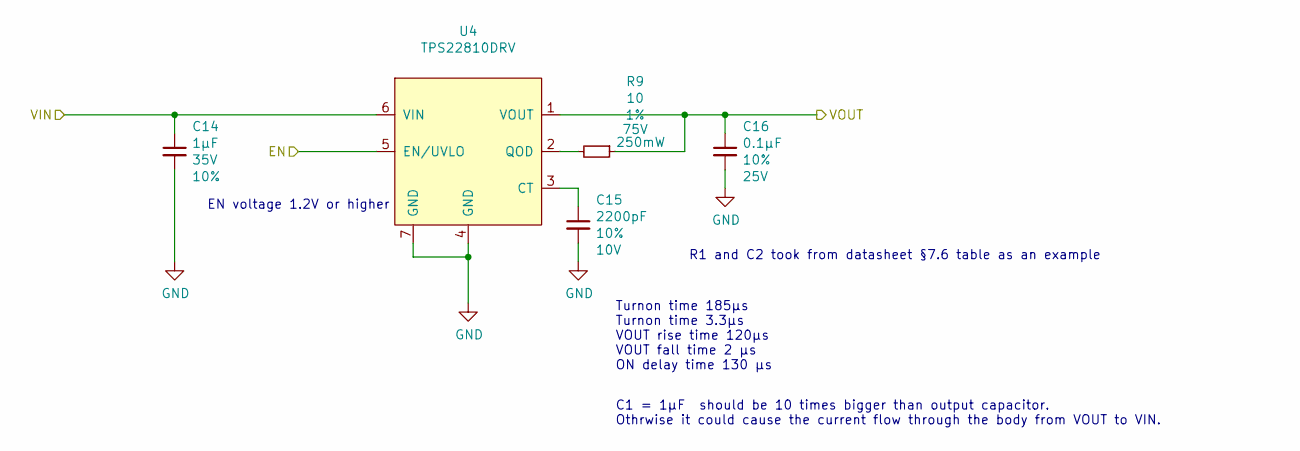
[picture p48: schematic tps22810.kicad_sch]

Parts:
C14: 1µF; C_0603_1608Metric_Pad1.08x0.95mm_HandSolder; Voltage 35V; Tolerance 10%
C15: 2200pF; C_0402_1005Metric_Pad0.74x0.62mm_HandSolder; Tolerance 10%; Voltage 10V
C16: 0.1µF; C_0603_1608Metric_Pad1.08x0.95mm_HandSolder; Tolerance 10%; Voltage 25V
R9: 10; R_0603_1608Metric_Pad0.98x0.95mm_HandSolder; Tolerance 1%; Voltage 75V
U4: TPS22810DRV; TPS22810DRVR

Connections:
EN: U4.5 (EN/UVLO)
GND: C14.2, C15.2, C16.2, U4.4 (GND), U4.7 (GND)
unnamed: C15.1, U4.3 (CT)
unnamed: R9.2, U4.2 (QOD)
VIN: C14.1, U4.6 (VIN)
VOUT: C16.1, R9.1, U4.1 (VOUT)

Notes on the sheet:
C1 = 1µF should be 10 times bigger than output capacitor. Othrwise it could cause the current flow through the body from VOUT to VIN.
R1 and C2 took from datasheet §7.6 table as an example
EN voltage 1.2V or higher
Turnon time 185µs Turnon time 3.3µs VOUT rise time 120µs VOUT fall time 2 µs ON delay time 130 µs
