ber2rv/fluidic/fluidics/tsic506f.kicad_sch

## KiCad design fluidics/tsic506f.kicad_sch (2024-05-15)

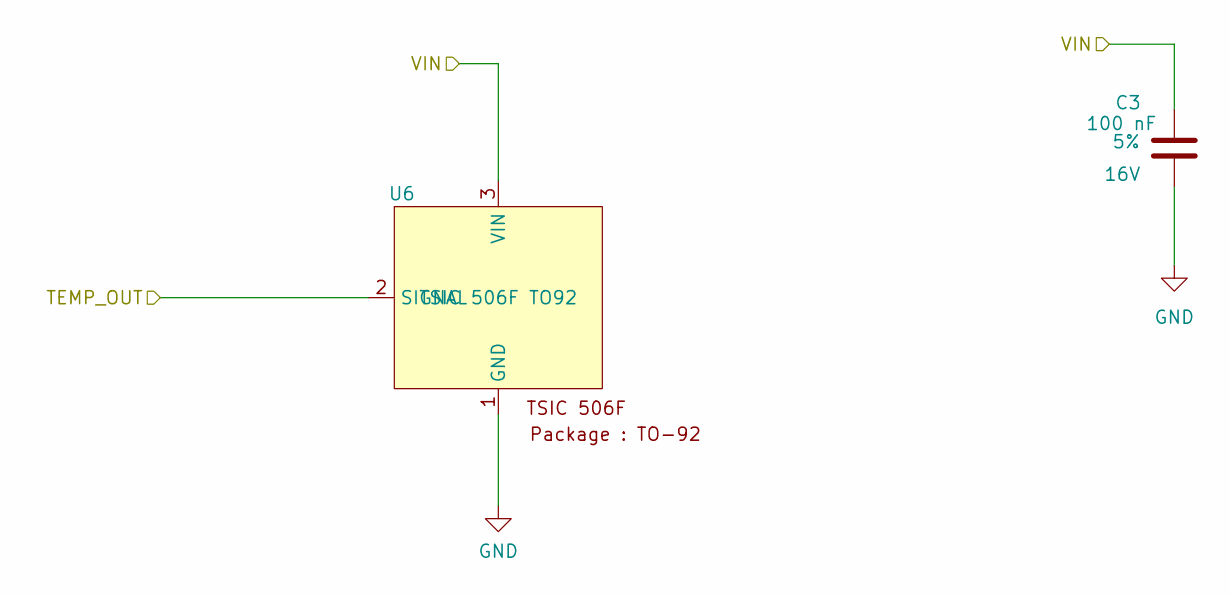
[picture p49: schematic tsic506f.kicad_sch]

Parts:
C3: 100 nF; C_0402_1005Metric_Pad0.74x0.62mm_HandSolder; Tolerance 5%; Voltage 16V
U6: TSIC 506F TO92

Connections:
GND: C3.1, U6.1 (GND)
TEMP_OUT: U6.2 (SIGNAL)
VIN: C3.2, U6.3 (VIN)
