ber2rv/fluidic/(commit log)

2024-05-15 Added design files
    [BD9D321EFJ-E2_dcdc_5V.kicad_sch, DRV8841.kicad_sch, LDO_5V_3.kicad_sch, emi_filter_dc_dc.kicad_sch, fluidic_system.kicad_sch, fluidics.kicad_sch, freerouting.dsn, imu_mpu6050.kicad_sch]
2024-05-15 added schematics
